iic-jku/ihp-sg13g2-ams-chip-template/doc/README.md

# Documentation

Reference material for this chip and for the IHP SG13G2 Open-PDK it is built on.

## This chip

| Document | Contents |
| --- | --- |
| [specifications.md](specifications.md) | Top-level specifications: technology, supplies, clock, corner list, macro inventory, functional behaviour of every block. |
| [pinout.md](pinout.md) | The full 32-pad table per side, with the `chip_top` port and the role each pad carries inside `chip_core`. |
| [floorplan.md](floorplan.md) | Die and core geometry, hard-macro placement coordinates, the PDN strategy and the floorplan diagram. |

The three are cross-linked and are written against the design files, not the other way round. If you change a number in [flow/librelane/config.yaml](../flow/librelane/config.yaml), [rtl/](../rtl/) or [packaging/config.yaml](../packaging/config.yaml), mirror it here.

## Tools

| Document | Contents |
| --- | --- |
| [klayout/klayout_cheatsheet.md](klayout/klayout_cheatsheet.md) | KLayout for this PDK: shortcuts, the `SG13_dev` PCell list, layer roles, padframe components, the DRC and LVS menu entries. |
| [librelane/librelane_cheatsheet.md](librelane/librelane_cheatsheet.md) | LibreLane `final/` directory anatomy, non-default routing rules, the complete SG13G2 via and metal-stack tables, the eight LEF/DEF orientations. |
| [verilog/](verilog/) | Verilog and SystemVerilog cheatsheets (external documents, PDK-independent). |

## PDK

| Document | Contents |
| --- | --- |
| [ihp-sg13g2-Open-PDK/sg13g2_os_layout_rules.pdf](ihp-sg13g2-Open-PDK/sg13g2_os_layout_rules.pdf) | The IHP layout rules. The authoritative source when a tool deck and a datasheet disagree. |
| [ihp-sg13g2-Open-PDK/sg13g2_os_process_spec.pdf](ihp-sg13g2-Open-PDK/sg13g2_os_process_spec.pdf) | The IHP process specification. |
| [ihp-sg13g2-Open-PDK/sg13g2_os_layout_cheatsheet.xlsx](ihp-sg13g2-Open-PDK/sg13g2_os_layout_cheatsheet.xlsx) | One sheet of formulas for wire resistance, parasitic capacitance and DC current limits. Read the caveats below before using it. |
| [ihp-sg13g2-Open-PDK/sg13g2_ngspice_mc_mm_guide.md](ihp-sg13g2-Open-PDK/sg13g2_ngspice_mc_mm_guide.md) | How the ngspice model files fit together, what `mm_ok` and `num_sigmas` do, and which corner, Monte Carlo and mismatch runs are possible per device family. |
| [sizing/](sizing/) | gm/ID techsweep plot overviews for the LV and HV MOS devices, the data behind the sizing notebooks in [macros/inverter/scripts/sizing/](../macros/inverter/scripts/sizing/). |

## Other

[ihp-structure-proposals/](ihp-structure-proposals/) holds four proposed submission-repo layouts for IHP shuttle chips (an ADC, an LNA, an MCU and an op-amp), contributed to the discussion around a common directory structure. They are PDK-independent. The generator script that produced them, `gen_structure.py`, is deliberately not tracked (see [.gitignore](../.gitignore)).

## Provenance and caveats

- **The two PDK PDFs come from `libs.doc/doc/` of the PDK**, renamed to lower case to match the folder convention. Both are byte-identical to the copies the PDK ships as of 2026-08-25 (`IHP-Open-PDK @ bf898e9`, the PDK in the IIC-OSIC-TOOLS 2026.08 image): layout rules **Rev. 0.4 (2024-12-19)**, process specification **Rev. 1.2 (2023-12-20)**. The revision is on the title page of each document. A repo copy of a PDK document ages silently, so check that stamp against `$PDK_ROOT/$PDK/libs.doc/doc/` before letting one of these decide a rule.
- **The layout cheatsheet is a convenience, not a rule source.** Its resistance columns assume bulk-aluminium resistivity and come out roughly a factor of two optimistic against the `RESISTANCE RPERSQ` values in `sg13g2_tech.lef`, and its "min. Width" column lists 0.42 µm for TopMetal1 and 0.2 µm for TopMetal2 where the tech LEF says 1.64 µm and 2.0 µm (0.42 is the TopVia1 cut size). Take widths from the DRC deck, resistance from the tech LEF or from PEX, and the DC current limits from the tables in the [LibreLane cheatsheet](librelane/librelane_cheatsheet.md), which are read out of the tech LEF. The sheet's `Contact` current limit of 0.3 mA per cut exists only there, the tech LEF has no `DCCURRENTDENSITY` entry for `Cont`.
- **Nothing in `doc/` is generated by a make target.** It is all hand-maintained.
