iic-jku/ihp-sg13g2-ams-chip-template/doc/klayout/klayout_cheatsheet.md

# KLayout IHP Cheat Sheet

## Plugins

- **Productivity Suite** by Martin Köhler:

  <https://github.com/iic-jku/klayout-productivity-suite>

---

## Layout Tips

- Layout an inverter first and go through all the design steps and get used to KLayout.
- Place dummy resistors with minimum length above and below the actual resistor.
- Use alternating metal layers for horizontal (M3/M5/TM2) and vertical (M2/M4/TM1) connections to minimize coupling.
- Restrict routing within the sub-circuit to lower metal layers: M1-M3
- Route sensitive signals first.
- Avoid the shadowing effect (orient the bias transistor in the same direction as the mirror transistor).
- Use self-made decoupling capacitors with NMOS capacitors at the bottom (for low-Q decoupling) and metal capacitors between each layer with alternating (vertical and horizontal) VIA contacts.
  - This fixes ringing that would otherwise occur when bond-wire inductance and high-Q MIM capacitors resonate.
  - Example stack: NMOS (VDD) → M1 (VSS) → M2 (VDD), again alternating vertical and horizontal.
  - Alternative: Use PMOS instead of NMOS, as this often is recommended for better ESD robustness.
- **RF decoupling:** Add an additional RC circuit in series with the supply voltage.

---

## Project Start

1. Open KLayout in edit mode with `klayout -e` (or `ke`).
2. **File → New Layout**:
    - Choose top cell name
    - Set **Data Base Unit (DBU)** to **0.001 µm** → IMPORTANT for IHP Open-PDK*
3. **File → Open** a hierarchical layout (`.klay.gds`), which allows sub-cells / sub-cell trees.
4. Hide empty layers.
5. Place instances by selecting and dragging them in.

\* If the DBU has been set wrong (e.g. to **0.005 µm**), change the DBU and scale the layout accordingly afterwards:
- **File → Layout Properties** → set DBU = `0.001 µm`
- **Edit → Layout → Scale** → enter `5.0` → press **OK** only (not *Apply + OK*, otherwise it scales 25 times → reported KLayout bug)
---

## Add Shortcuts

1. **File → Setup**
2. Customize Menu
3. Search for function and enter shortcut

---

## Net Tracer

1. **Tools → Trace Net**
2. Configure: tick `Halo`, `line width` = 3pixel, 90% `intensity increase`
3. Search for function and enter shortcut

---

## Enable Layer Numbers

1. **File → Setup**
2. Layer Properties
3. Tick *Always show layer source in layer list*

---

## Libraries (`.klib` File, Hierarchical Layout Only)

- Add entries in the `.klib` file:
  - Manually directly to the `.klib` file
  - In the GUI via "File / Cell Library Manager Map"
- Works for both `.gds` and `.klay.gds`.
- Build the cell tree bottom-up.

Common SG13_dev PCells:

- Transistors: `pmos`, `nmos` (low-voltage)
- Resistors: `rppd`, `rsil`, `rhigh`
- Capacitors: `cmim`
- Well/substrate contacts: `guard_ring`
- Vias:
  - `via_stack` from `SG13_dev`
  - `Via` from `SG13_native_pcell_lib library`
- etc.

---

## Layer Roles

- `MetalX.drawing`: actual connections
- `MetalX.pin`: input, output, inout pins placement
- `MetalX.text`: label of the pins
- Use filler layers later for final density closure.

---

## Padframe

| Component | Notes |
| --- | --- |
| Seal ring | Place at origin with `Shift + O` (25 µm offset) |
| IHP Pads | |
| RF Pads | add VIA ring for robustness |
| IO Pads | 3.3 V |
| VDD / VSS Pads | 1.5 V |
| Bond Pads | 70µm x 70µm |

---

## Shortcuts

### General Editing

| Shortcut | Action |
| --- | --- |
| `Q` | Properties of selected objects/pcells |
| `P` | Path / drawing tool (double-click to finish) |
| `U` | Undo |
| `Shift + U` | Redo |
| `F` | Zoom full |
| `R` | Draw rectangle |
| `A` | Align tool: click on dot (middle / corner / edge) |
| `C` | Copy object |
| `M` | Move quickly (connections & movements: diagonal) |
| `T` | Place text |
| `K` | Ruler+ |
| `Shift + K` | Clear all Ruler+s |
| `Shift + C` | Toggle Crosshair Cursor |

### Pins & VIAs

| Shortcut | Action |
| --- | --- |
| `Shift + P` | Set pin (input, output, …) for LVS |
| `O` | Place VIAs during routing (pathmode) |
| | Manual VIA stack via IHP Pcells → drag out → `Q` → set layer input |

### Instance Manipulation

| Shortcut | Action |
| --- | --- |
| `E` | Descend into instance |
| `Ctrl + E`  | Ascend from instance |
| Middle Mouse Button | Show As New Top	 |
| `Shift + R` | Rotate instance by 90° |
| `Shift + H` | Flip instance horizontally |
| `Shift + V` | Flip instance vertically |
| `Shift + O` | Set origin |

### Hierarchy Visibility

| Shortcut | Action |
| --- | --- |
| `Ctrl + F`  | Hide all instances per hierarchy level |
| `Shift + F` | Show all instances per hierarchy level |

### Layer Visibility

| Key | Layer Focus |
| --- | --- |
| `0` | Show default layers |
| `,` | Hide default layers |
| `1` | 1st metal and related VIAs |
| `2` | 2nd metal and related VIAs |
| `3` | 3rd metal and related VIAs |
| `4` | 4th metal and related VIAs |
| `5` | 5th metal and related VIAs |
| `6` | 6th metal and related VIAs |
| `7` | 7th metal and related VIAs |
| `8` | Gate poly and related layers |
| `9` | Diffusion and related layers |
| `Shift+1` | Extend the focus to include 1st metal and related vias |
| `Shift+2` | Extend the focus to include 2nd metal and related vias |
| `Shift+3` | Extend the focus to include 3rd metal and related vias |
| `Shift+4` | Extend the focus to include 4th metal and related vias |
| `Shift+5` | Extend the focus to include 5th metal and related vias |
| `Shift+6` | Extend the focus to include 6th metal and related vias |
| `Shift+7` | Extend the focus to include 7th metal and related vias |
| `Shift+8` | Extend the focus to include Gate Poly and related vias |
| `Shift+9` | Extend the focus to include Diffusion and related vias |

---

## LVS (Layout vs. Schematic)

- Open-Source Tool Check
  - Xschem:
    - **Simulation → LVS → untick "Use 'spiceprefix' attribute"**
    - **Simulation → LVS → tick "LVS netlist + Top level is a .subckt" and "Upper case .SUBCKT and .ENDS"**
    - **Simulation → "Set top level netlist name" → enter top level netlist name (equals file name + `.cdl` or `.spice`)**
    - **Right top corner → click on "create netlist" → creates a `.cdl` or `.spice` file**
  - KLayout:
    - Rename the cell to match the LVS netlist name
    - **SG13G2 → SG13G2 LVS Options (`F12`) → set "Netlist Path"**
    - **Run KLayout LVS (`F11`)**

---

## DRC (Design Rule Check)

- Open-Source Tool Check
  - KLayout:
    - **SG13G2 → SG13G2 DRC Options (`F10`)**
      - Set the extra rule set (do **not** disable it).
      - **Advanced settings:**
        - Disable density checks (only at the beginning).
        - Enable antenna checks.
    - **Run KLayout DRC (`F9`)**

---

## Makefiles

- Every macro folder contains Makefile targets for common verification and extraction flows, including DRC, LVS, and PEX with KLayout or Magic & Netgen.

---
