iic-jku/ihp-sg13g2-ams-chip-template/ip/sg13g2_ip__jku_names/README.md

# sg13g2_ip__jku_names

A names IP block for [Johannes Kepler University Linz](https://www.jku.at/), rendered as a GDSII layout on a configurable metal layer (default `Metal5`) with `NoMetFiller` for the IHP SG13G2 130 nm CMOS process.

## Directory Structure

<details>
<summary>Show Directory Structure</summary>

```text
📁 sg13g2_ip__jku_names/
├─ Makefile                         # Build automation
├─ 📁 logo/
│  └─ jku_names.png                 # Source PNG image
├─ 📁 script/
│  └─ img2lay.py                    # PNG-to-GDS converter
├─ 📁 final/
│  ├─ 📁 gds/
│  │  └─ sg13g2_ip__jku_names.gds   # Generated GDSII layout
│  ├─ 📁 lef/
│  │  └─ sg13g2_ip__jku_names.lef   # LEF macro for place-and-route
│  ├─ 📁 lib/
│  │  └─ sg13g2_ip__jku_names.lib   # Liberty timing stub
│  └─ 📁 vh/
│     └─ sg13g2_ip__jku_names.vh    # Verilog blackbox stub
└─ 📁 verification/
   └─ 📁 drc/                       # DRC reports
```

</details>

## Usage

The default Make target is `help`, so running `make` prints usage and all available targets with short descriptions.

```bash
make
make help
```

Build everything (clean, generate logo GDS, LEF, Liberty, Verilog stub, run DRC):

```bash
make all
```

### Individual Targets

| Target | Description |
|---|---|
| `logo` | Convert PNG to GDSII using `img2lay.py` |
| `lef` | Generate LEF macro (CLASS BLOCK, OBS on `$(LAYER_NAME)`) |
| `lib` | Generate Liberty timing stub (empty cell) |
| `verilog` | Generate Verilog blackbox stub (no ports) |
| `klayout-drc` | Run KLayout DRC using `sak-drc.sh` (usage: `make klayout-drc [CELL=<cellname>] [DRC_LEVEL=<precheck\|macro\|regular>]`) |
| `magic-drc` | Run Magic DRC using `sak-drc.sh` (usage: `make magic-drc [CELL=<cellname>]`) |
| `open` | Browse this folder with `sak-open.py` and open each file in its tool |
| `clean` | Remove all generated output directories |

### Parameters

The following Makefile variables can be overridden:

| Variable | Default  | Description |
|---|---|---|
| `IMG_SIZE_PX` | `750` | Source image width/height in pixels |
| `BLOCK_SIZE`  | `100` | Desired physical block size in µm |
| `PIXEL_SIZE`  | `0.25` | Pixel size in µm (must be ≥ M5 min width of 0.21 µm to avoid DRC violations) |
| `LAYER` | `Metal5` | Metal layer the logo is drawn on; one of `Metal1`..`Metal5`, `TopMetal1`, `TopMetal2` |

Setting `LAYER` keeps the GDS artwork (`logo` target) and the LEF obstruction (`lef` target) consistent. The Makefile derives both `LAYER_NUM` (e.g. `67/0`) and `LAYER_NAME` (e.g. `Metal5`) from it.

```sh
make all LAYER=TopMetal1
```

The image scale factor is computed automatically.

## Logo Generator Script

The `script/img2lay.py` script converts a PNG image into a GDSII layout:

- Each dark pixel becomes a rectangle on the layer selected via `LAYER` (default `Metal5` → `67/0`)
- Boundary layers 189/0 (`prBoundary`) and 160/0 (`NoMetFiller`) mark the block outline
- `--invert` inverts the image (dark ↔ light)
- `--merge` merges adjacent rectangles to reduce polygon count
- `--pixel-size` sets the physical size of each pixel in µm
- `--scale` downscales the image before conversion

## Design Rule Check (DRC)

Runs DRC on the GDS layout in `final/gds/`. Both flows use `sak-drc.sh` and write their reports into per-cell run folders: `verification/drc/<CELL>.magic.drc/` (Magic) and `verification/drc/<CELL>.klayout.drc/` (KLayout, `.lyrdb`).

**KLayout DRC** uses `sak-drc.sh` at the selected `DRC_LEVEL` (`precheck`, `macro` [default], or `regular`):

```sh
make klayout-drc
make klayout-drc CELL=sg13g2_ip__jku_names
make klayout-drc DRC_LEVEL=regular
```

**Magic DRC** uses `sak-drc.sh`:

```sh
make magic-drc
make magic-drc CELL=sg13g2_ip__jku_names
```
