iic-jku/ihp-sg13g2-ams-chip-template/doc/ihp-structure-proposals/IHP__ADC5871-structure.md

# IHP__ADC5871 structure

```
📁 IHP__ADC5871/
├── 📁 ADC5871-main/
│   ├── 📁 layout/
│   │   ├── 📁 def/
│   │   ├── 📁 klayout/
│   │   ├── 📁 lef/
│   │   └── 📁 magic/
│   ├── 📁 model/
│   │   ├── 📁 spice/
│   │   └── 📁 verilog-A/
│   ├── 📁 netlist/
│   │   ├── 📁 layout/
│   │   ├── 📁 pex/
│   │   ├── 📁 rcx/
│   │   └── 📁 schematic/
│   ├── 📁 schematic/
│   │   ├── 📁 qucs-s/
│   │   └── 📁 xschem/
│   ├── 📁 testbenches/
│   │   ├── 📁 ac/
│   │   │   ├── 📁 qucs-s/
│   │   │   └── 📁 xschem/
│   │   ├── 📁 corners/
│   │   │   ├── 📁 qucs-s/
│   │   │   └── 📁 xschem/
│   │   ├── 📁 noise/
│   │   │   ├── 📁 qucs-s/
│   │   │   └── 📁 xschem/
│   │   └── 📁 tran/
│   │       ├── 📁 qucs-s/
│   │       └── 📁 xschem/
│   ├── 📁 timing/
│   ├── 📁 verification/
│   │   ├── 📁 drc/
│   │   └── 📁 lvs/
│   └── README.md
├── 📁 dependencies/
├── 📁 doc/
│   ├── Datasheet.md
│   ├── info.json
│   ├── Specification.md
│   └── TRL-Mixed-Signal-IP.md
├── 📁 measurements/
│   └── 📁 v.1.0.0/
├── 📁 release/
│   └── 📁 v.1.0.0/
│       ├── 📁 doc/
│       ├── 📁 gds/
│       ├── 📁 netlist/
│       └── ReleaseNote.md
└── README.md
```
