iic-jku/ihp-sg13g2-ams-chip-template/doc/ihp-structure-proposals/IHP__LNA1426-structure.md

# IHP__LNA1426 structure

```
📁 IHP__LNA1426/
├── 📁 dependencies/
├── 📁 doc/
│   ├── Datasheet.md
│   ├── info.json
│   ├── Specification.md
│   └── TRL-RF.md
├── 📁 LNA1426-main/
│   ├── 📁 layout/
│   │   ├── 📁 def/
│   │   ├── 📁 klayout/
│   │   ├── 📁 lef/
│   │   └── 📁 magic/
│   ├── 📁 model/
│   │   ├── 📁 spice/
│   │   └── 📁 verilog-A/
│   ├── 📁 netlist/
│   │   ├── 📁 layout/
│   │   ├── 📁 pex/
│   │   ├── 📁 rcx/
│   │   └── 📁 schematic/
│   ├── 📁 schematic/
│   │   ├── 📁 qucs-s/
│   │   └── 📁 xschem/
│   ├── 📁 testbenches/
│   │   ├── 📁 ac/
│   │   │   ├── 📁 qucs-s/
│   │   │   └── 📁 xschem/
│   │   ├── 📁 corners/
│   │   │   ├── 📁 qucs-s/
│   │   │   └── 📁 xschem/
│   │   ├── 📁 em/
│   │   ├── 📁 noise/
│   │   │   ├── 📁 qucs-s/
│   │   │   └── 📁 xschem/
│   │   └── 📁 tran/
│   │       ├── 📁 qucs-s/
│   │       └── 📁 xschem/
│   ├── 📁 verification/
│   │   ├── 📁 drc/
│   │   └── 📁 lvs/
│   └── README.md
├── 📁 measurements/
│   └── 📁 v.1.0.0/
├── 📁 release/
│   └── 📁 v.1.0.0/
│       ├── 📁 doc/
│       ├── 📁 gds/
│       ├── 📁 netlist/
│       └── ReleaseNote.md
└── README.md
```
