iic-jku/ihp-sg13g2-ams-chip-template/ToDo.md

# ToDo List

- [ ] update tutorial
    - no sizing guidance for `DIE_AREA`/`CORE_AREA` or the core ring
    - no explanation of `chip_top.sdc`
    - no description of the MACROS entry structure
    - no post-run checklist
- [ ] add VCO RF macro in branch `add-rf-macro`
- [ ] test and merge `hv-stdcell`: https://github.com/iic-jku/ihp-sg13g2-ams-chip-template/tree/test-hv-stdcell
- [ ] check and merge `gdscheck-drc`: https://github.com/iic-jku/ihp-sg13g2-ams-chip-template/pull/7
- [ ] `ngspice` & `verilog` RTL Co-Simulation using `Xschem`: https://www.youtube.com/watch?v=PPd7jkcHOgA
- [ ] add VACASK testbenches to inverter macro (update Makefile + README, see `add-vacask` branch)
- [ ] add VACASK mixed-signal GL testbenches to counter macro (update Makefile + README, see `add-vacask` branch)
- [ ] clean up top-level LVS (Magic + Netgen, KLayout ?) --> see / merge `top-level-lvs` branch
- [ ] merge `fixed-auto-taper` branch (wait until `librelane-openroad` is updated)
- [ ] finish and merge `exercise-solution` branch
- [ ] add custom LibreLane step for filler insertion after ArtistIC added logo --> see / merge `custom-librelane-steps` branch
    - flow without filler (GDS streamout + DRC check) --> default
    - add logo with ArtistIC --> custom
    - add filler structures --> custom
        - KLayout & Magic Filler: https://librelane.readthedocs.io/en/stable/reference/step_config_vars.html
        - add GDSFill to `config.yaml`: https://github.com/aesc-silicon/gdsfill 
    - GDS streamout + DRC check --> custom
- [ ] add custom LibreLane step for power estimation (counter macro & top-level)
- [ ] add sg13g2_Filler2000_novdd to split VDD_CORE & VDD_ANA (split voltage domains)
- [ ] add sg13g2_io_custom to iic-jku/IHP-Open-PDK
- [ ] add YouTube tutorial
- [ ] add Blender renders
- [ ] PR IHP sizing scripts
- [ ] RTL Co-Simulation using `SpiceBind`
- [ ] add PF SimulatePARALLEL testbench
- [ ] save markdown report of CACE
- [ ] update table "Folder" column width
