iic-jku/ihp-sg13g2-ams-chip-template/macros/counter/render/img/counter_top_librelane.png

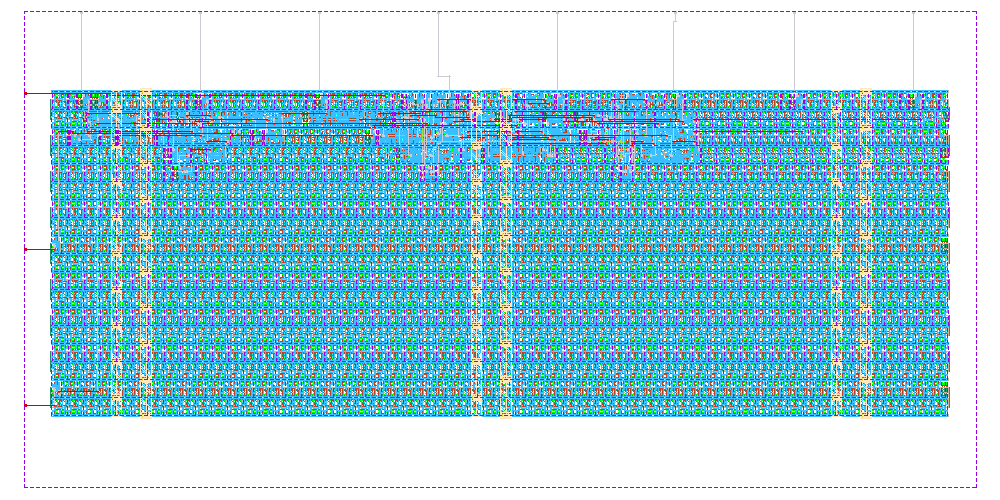
macros/counter/render/img/counter_top_librelane.png
