iic-jku/ihp-sg13g2-ams-chip-template/macros/inverter/render/img/inverter_top_black.png

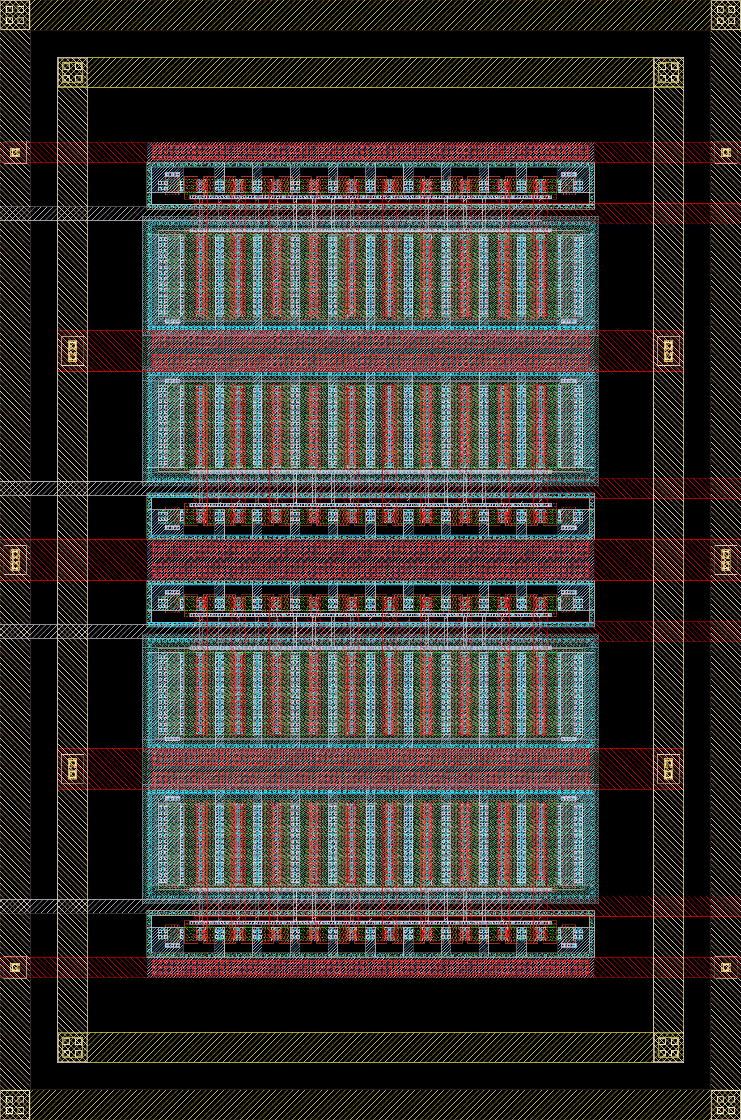
macros/inverter/render/img/inverter_top_black.png
