iic-jku/ihp-sg13g2-ams-chip-template/packaging/render/chip_top_bondplan_black.png

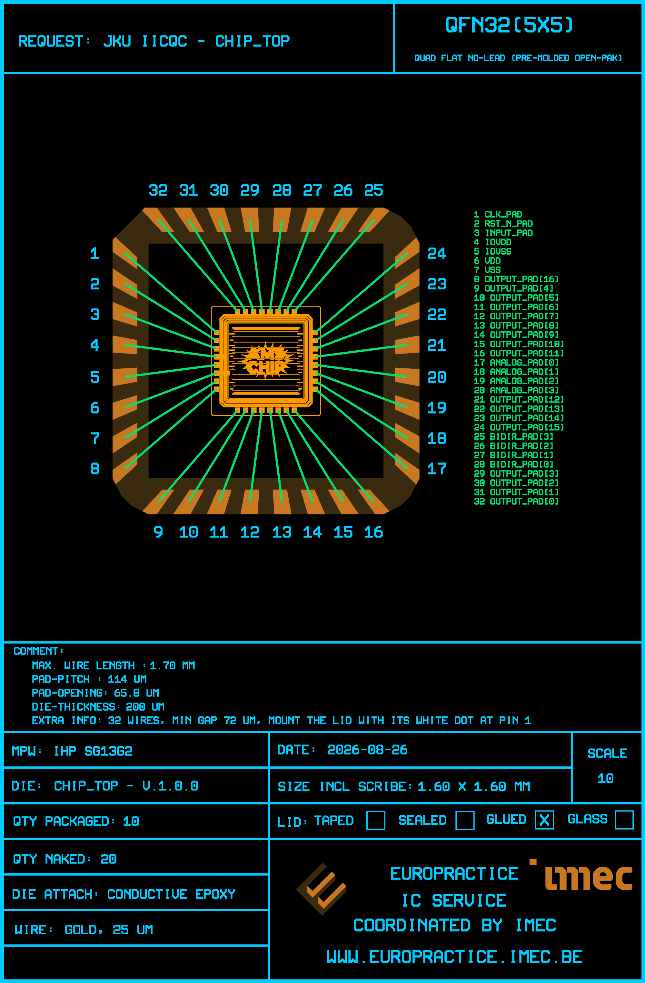
packaging/render/chip_top_bondplan_black.png
