iic-jku/ihp-sg13g2-ams-chip-template/release/v.1.0.0/img/chip_top_black_TM2.png

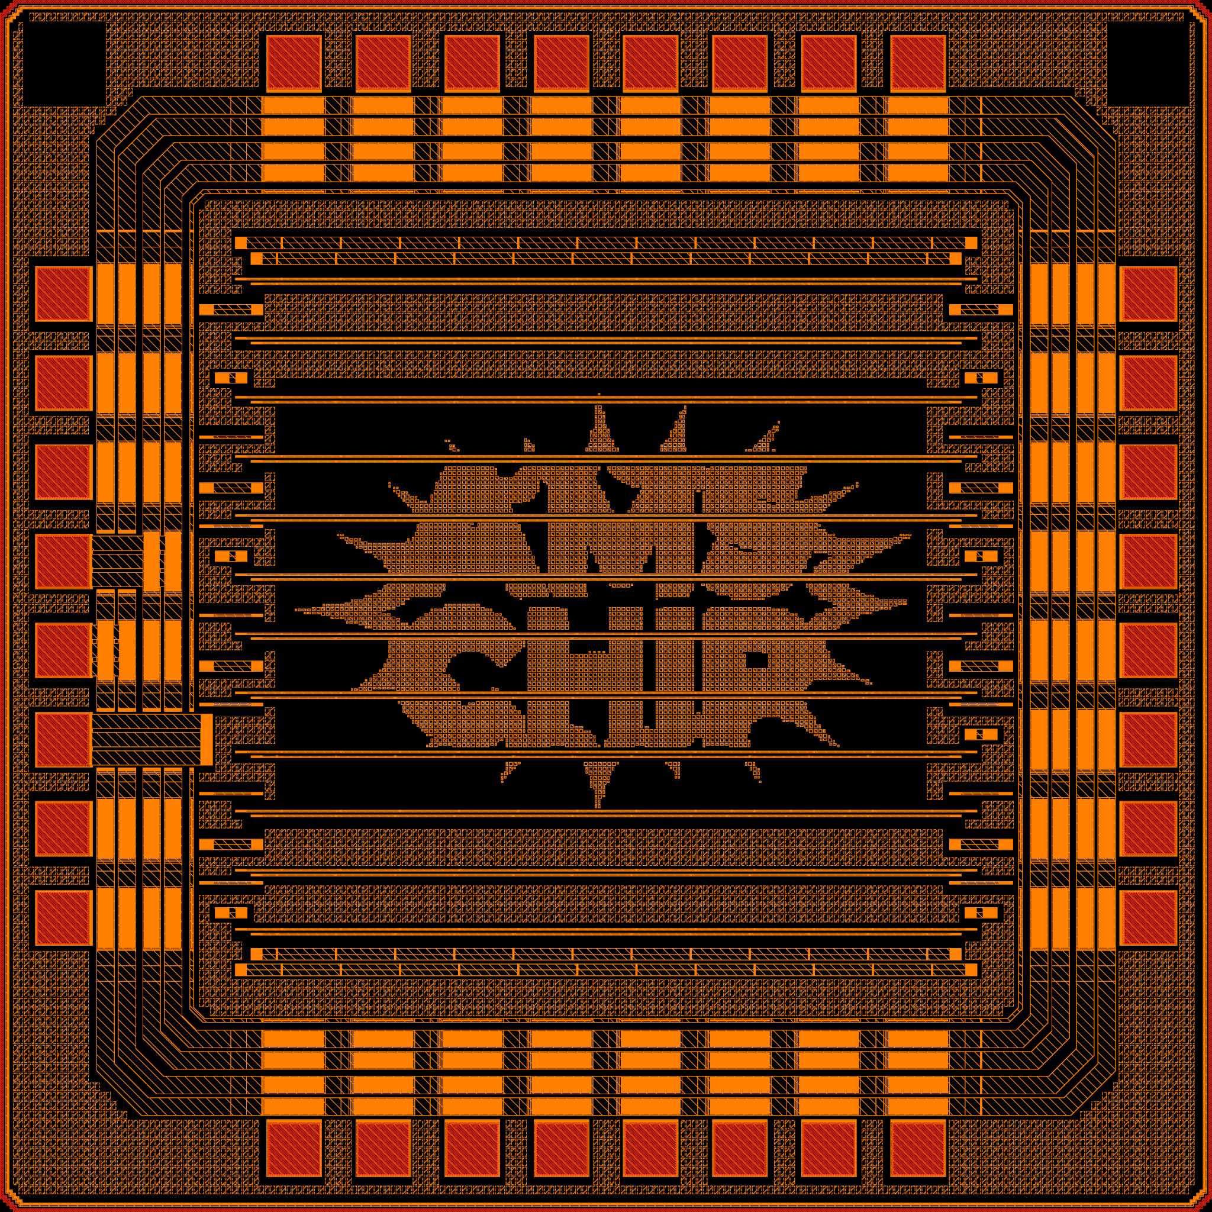
release/v.1.0.0/img/chip_top_black_TM2.png
