iic-jku/ihp-sg13g2-ams-chip-template/release/v.1.0.0/img/chip_top_librelane.png

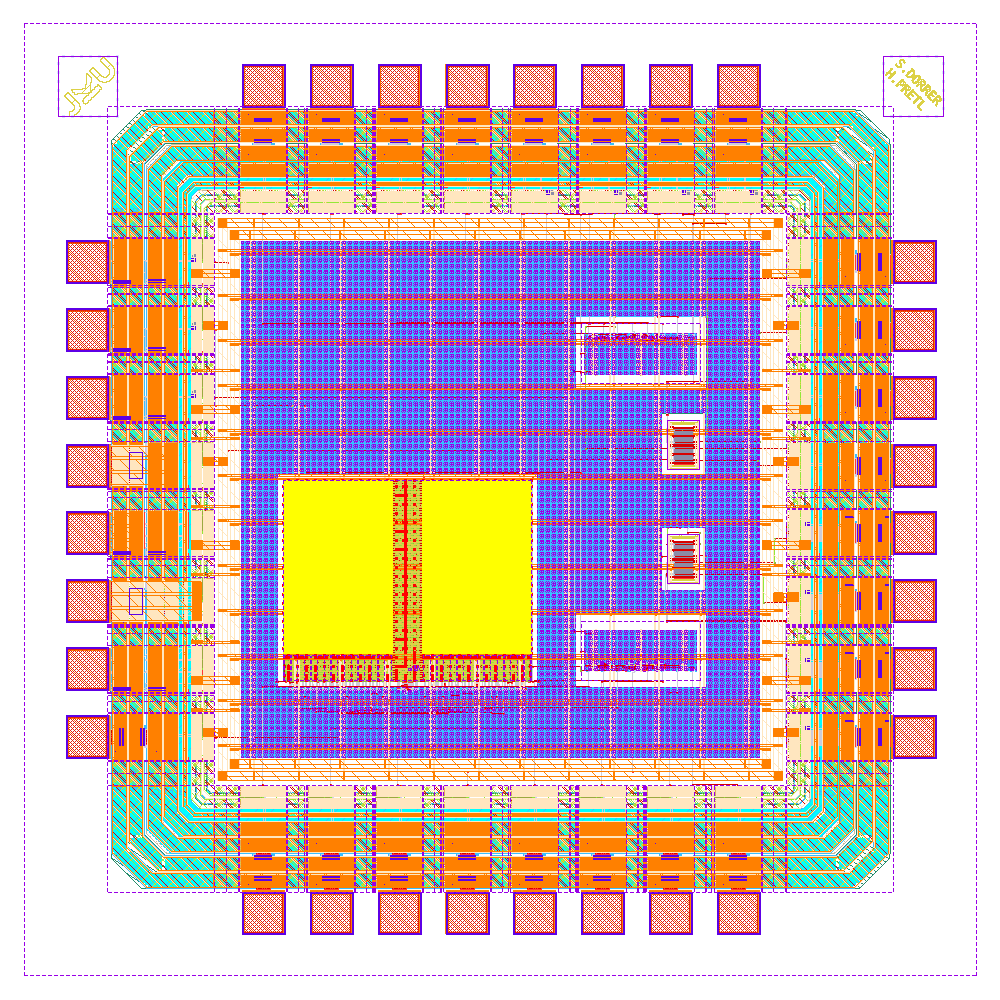
release/v.1.0.0/img/chip_top_librelane.png
