iic-jku/ihp-sg13g2-ams-chip-template/tutorial/fig/tools_overview/tools_overview.png

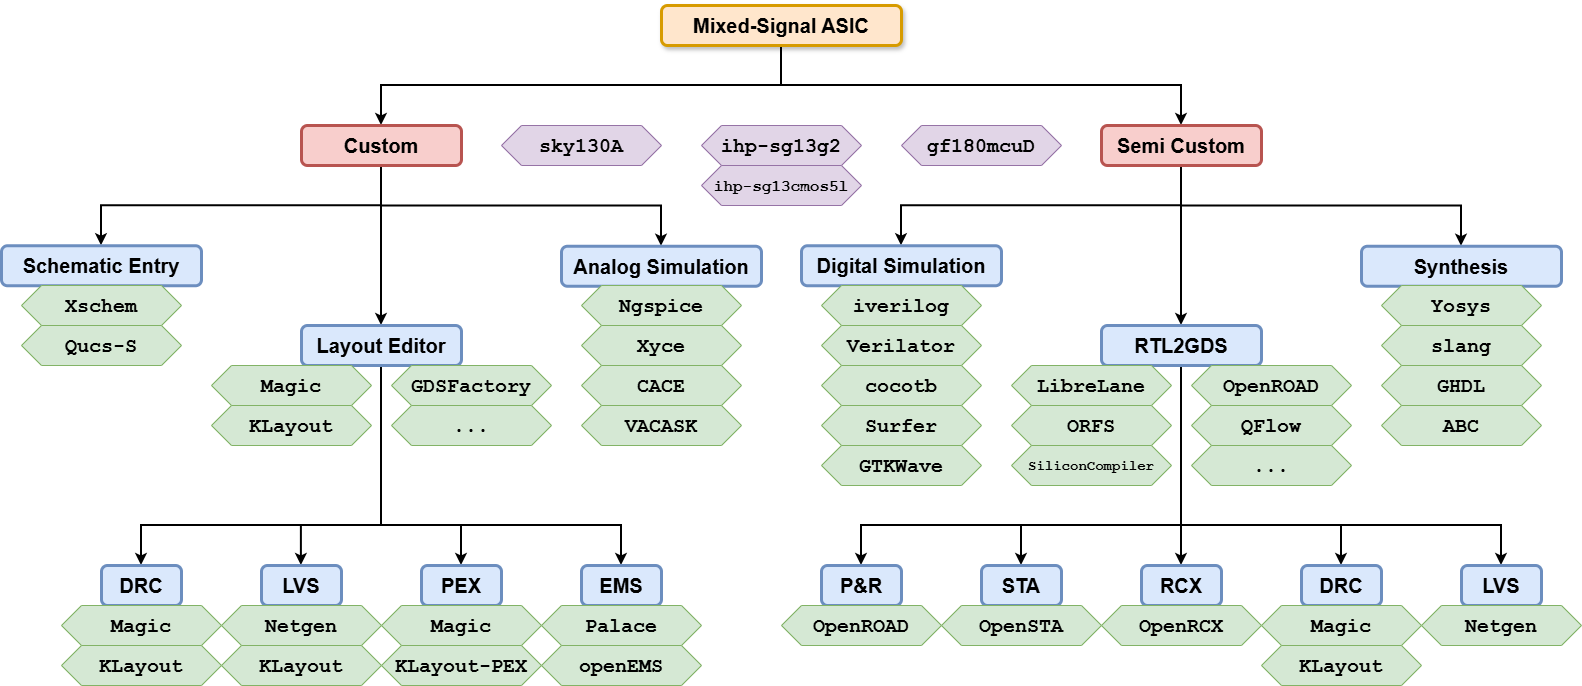
tutorial/fig/tools_overview/tools_overview.png
