iic-jku/ihp-sg13g2-ams-chip-template/macros/inverter/testbenches/xschem/plot_simulations/figures/inverter_tb_ac_ol.pdf

### Inverter - AC Open-Loop Response

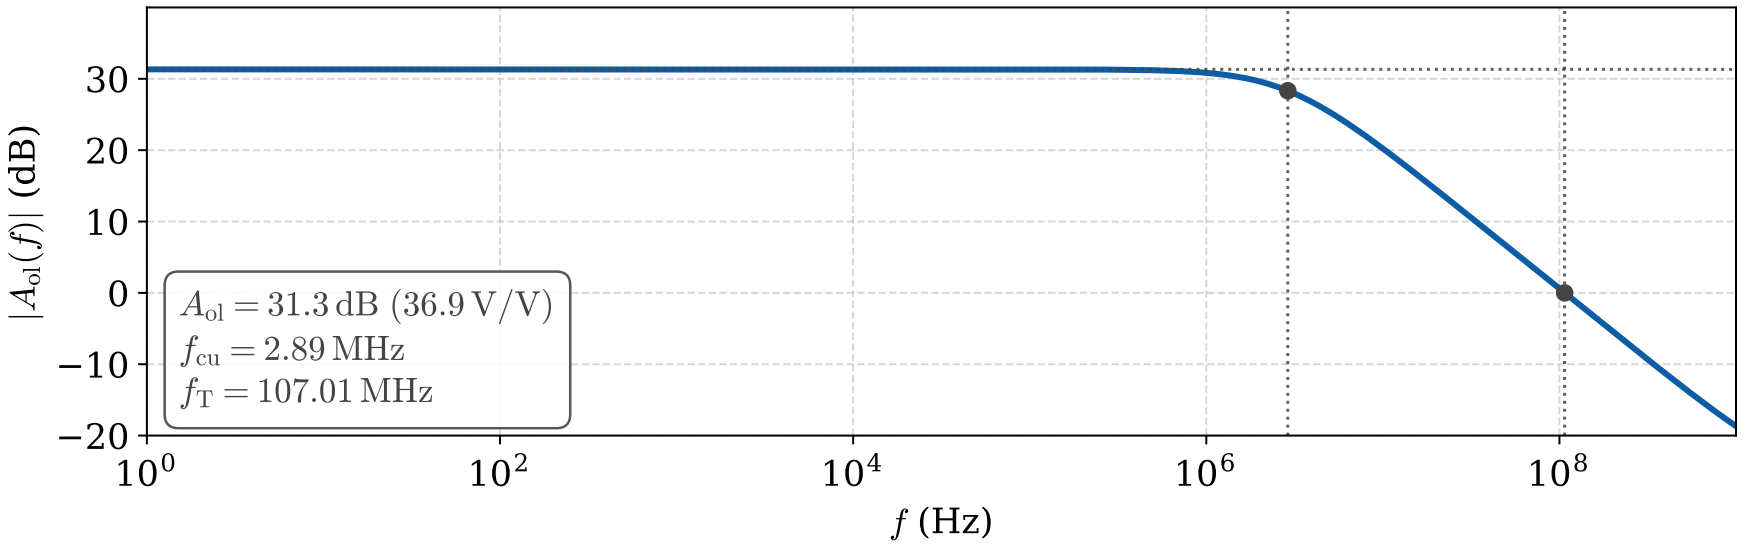
[picture p72: figure]
jAol(f)j (d; Aol = 31:3 dB (36:9 V=V) fcu = 2:89 MHz; fT = 107:01 MHz
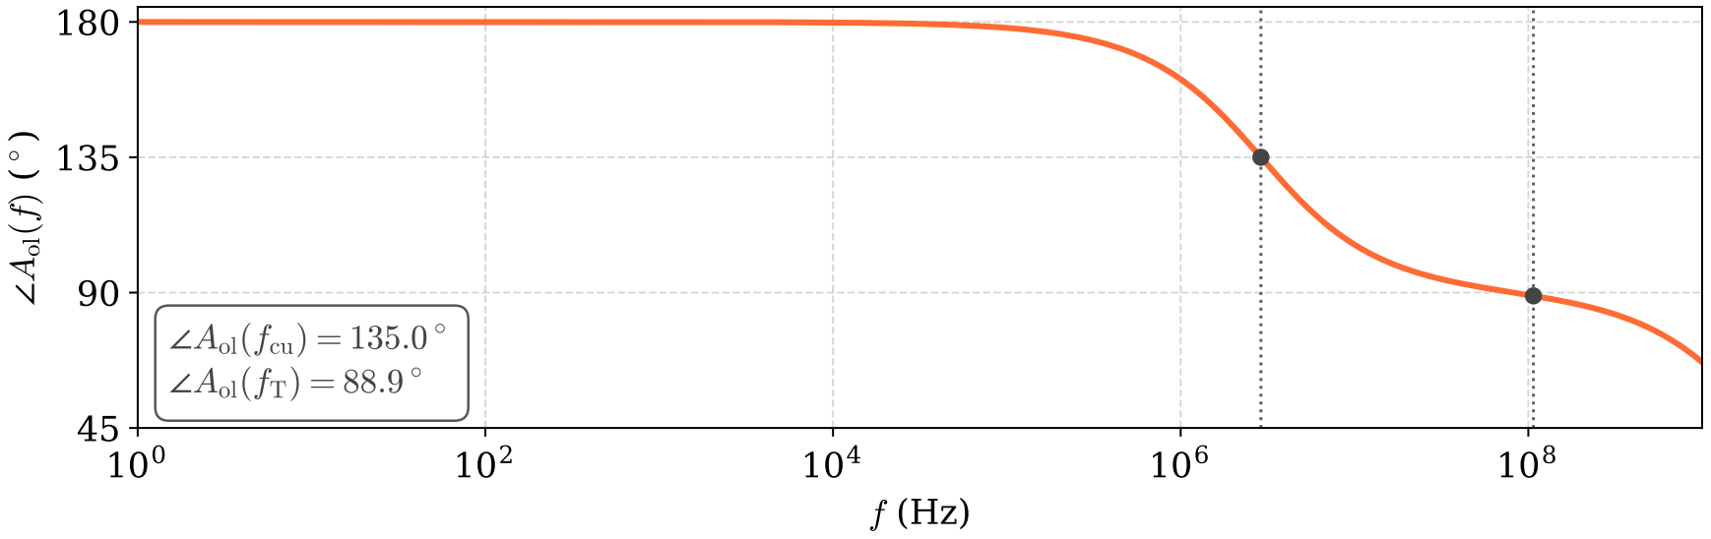
[picture p73: figure]
Aol(f) (; ∠Aol(fcu) = 135:0; ∠Aol(fT) = 88:9
