iic-jku/ihp-sg13g2-ams-chip-template/testbenches/xschem/plot_simulations/figures/chip_top_tb_tran_analog_inv.pdf

Chip Top

— Analog Inverter (INV2)

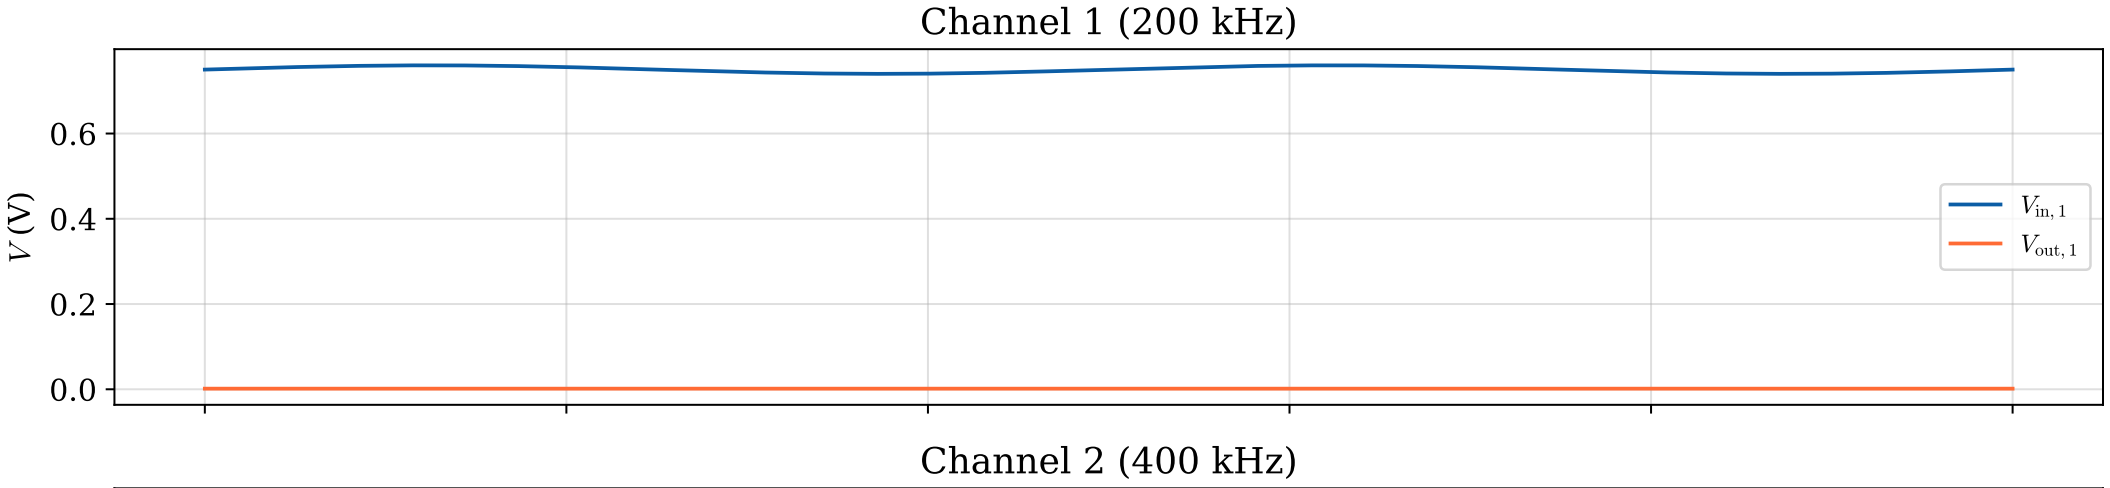
[picture p74: figure]
Channel 1 (200 kHz); Channel 2 (400 kHz)
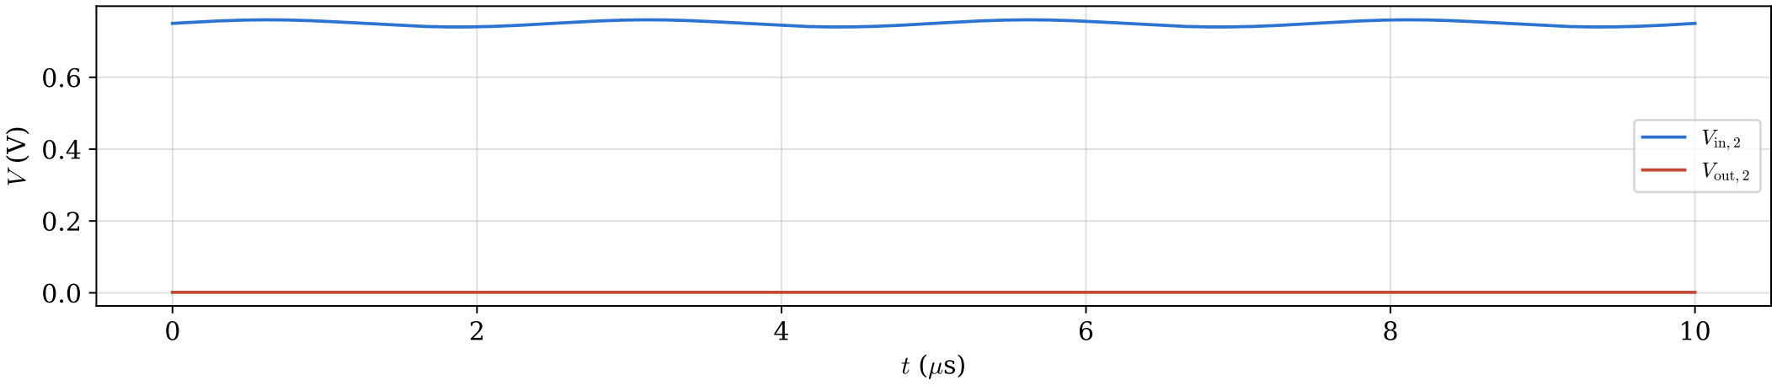
[picture p75: figure]
