iic-jku/ihp-sg13g2-ams-chip-template/macros/inverter/verification/cace/scripts/inverter_tb_ac.csv

Adc_ol_dB_arr | fcu_arr
3.233319999999999794e+01 | 2.770820000000000000e+06
1.569359999999999999e+01 | 1.498760000000000000e+07
1.684240000000000137e+01 | 1.415100000000000000e+07
3.355180000000000007e+01 | 2.253940000000000000e+06
1.964890000000000114e+01 | 1.016710000000000000e+07
3.318299999999999983e+01 | 2.432850000000000000e+06
1.549210000000000065e+01 | 1.466710000000000000e+07
1.714649999999999963e+01 | 1.217430000000000000e+07
8.209319999999999951e+00 | 3.240640000000000000e+07
2.650779999999999959e+01 | 4.716980000000000000e+06
1.192699999999999960e+01 | 2.323780000000000000e+07
1.591879999999999917e+01 | 1.531210000000000000e+07
9.953920000000000101e+00 | 2.865190000000000000e+07
1.524510000000000076e+01 | 1.604600000000000000e+07
3.349900000000000233e+01 | 2.284840000000000000e+06
3.252179999999999893e+01 | 2.516820000000000000e+06
3.022019999999999840e+01 | 3.188520000000000000e+06
2.313899999999999935e+01 | 7.092750000000000000e+06
7.639669999999999739e+00 | 3.074810000000000000e+07
1.581579999999999941e+01 | 1.614560000000000000e+07
6.617630000000000123e+00 | 3.729670000000000000e+07
1.583300000000000018e+01 | 1.536930000000000000e+07
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
