iic-jku/ihp-sg13g2-ams-chip-template/macros/inverter/testbenches/xschem/plot_simulations/figures/inverter_top_tb_tran.csv

time_ms | vin | vout1 | vout2 | vout3 | vout4
0.000000000000000000e+00 | 7.500000000000000000e-01 | 5.371804869999999843e-01 | 5.371804869999999843e-01 | 5.371804869999999843e-01 | 5.371804869999999843e-01
1.000000000000000082e-05 | 7.500006280000000025e-01 | 5.371769410000000189e-01 | 5.371769410000000189e-01 | 5.371769410000000189e-01 | 5.371769410000000189e-01
2.000000000000000164e-05 | 7.500012569999999767e-01 | 5.371703709999999798e-01 | 5.371703709999999798e-01 | 5.371703709999999798e-01 | 5.371703709999999798e-01
4.000000000000000327e-05 | 7.500025129999999818e-01 | 5.371512769999999826e-01 | 5.371512769999999826e-01 | 5.371512769999999826e-01 | 5.371512769999999826e-01
8.000000000000000654e-05 | 7.500050270000000463e-01 | 5.370932120000000420e-01 | 5.370932120000000420e-01 | 5.370932120000000420e-01 | 5.370932120000000420e-01
1.600000000000000131e-04 | 7.500100530000000099e-01 | 5.369363689999999689e-01 | 5.369363689999999689e-01 | 5.369363689999999689e-01 | 5.369363689999999689e-01
3.200000000000000262e-04 | 7.500201060000000197e-01 | 5.365749749999999541e-01 | 5.365749749999999541e-01 | 5.365749749999999541e-01 | 5.365749749999999541e-01
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
