iic-jku/ihp-sg13g2-ams-chip-template/macros/inverter/verification/cace/results/inverter/Adc_ol_dB_mc.png

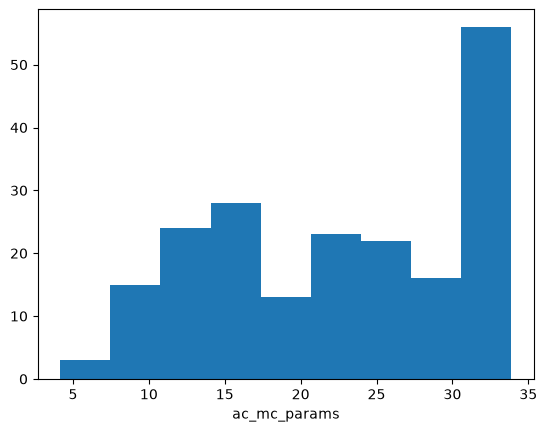
macros/inverter/verification/cace/results/inverter/Adc_ol_dB_mc.png
