iic-jku/ihp-sg13g2-ams-chip-template/macros/inverter/verification/cace/results/inverter/fcu_mc.png

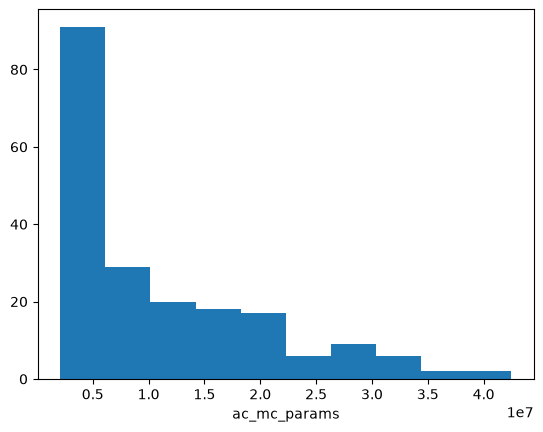
macros/inverter/verification/cace/results/inverter/fcu_mc.png
