iic-jku/ihp-sg13g2-ams-chip-template/doc/sizing/techsweep_sg13g2_lv_nmos_plots_overview.pdf

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

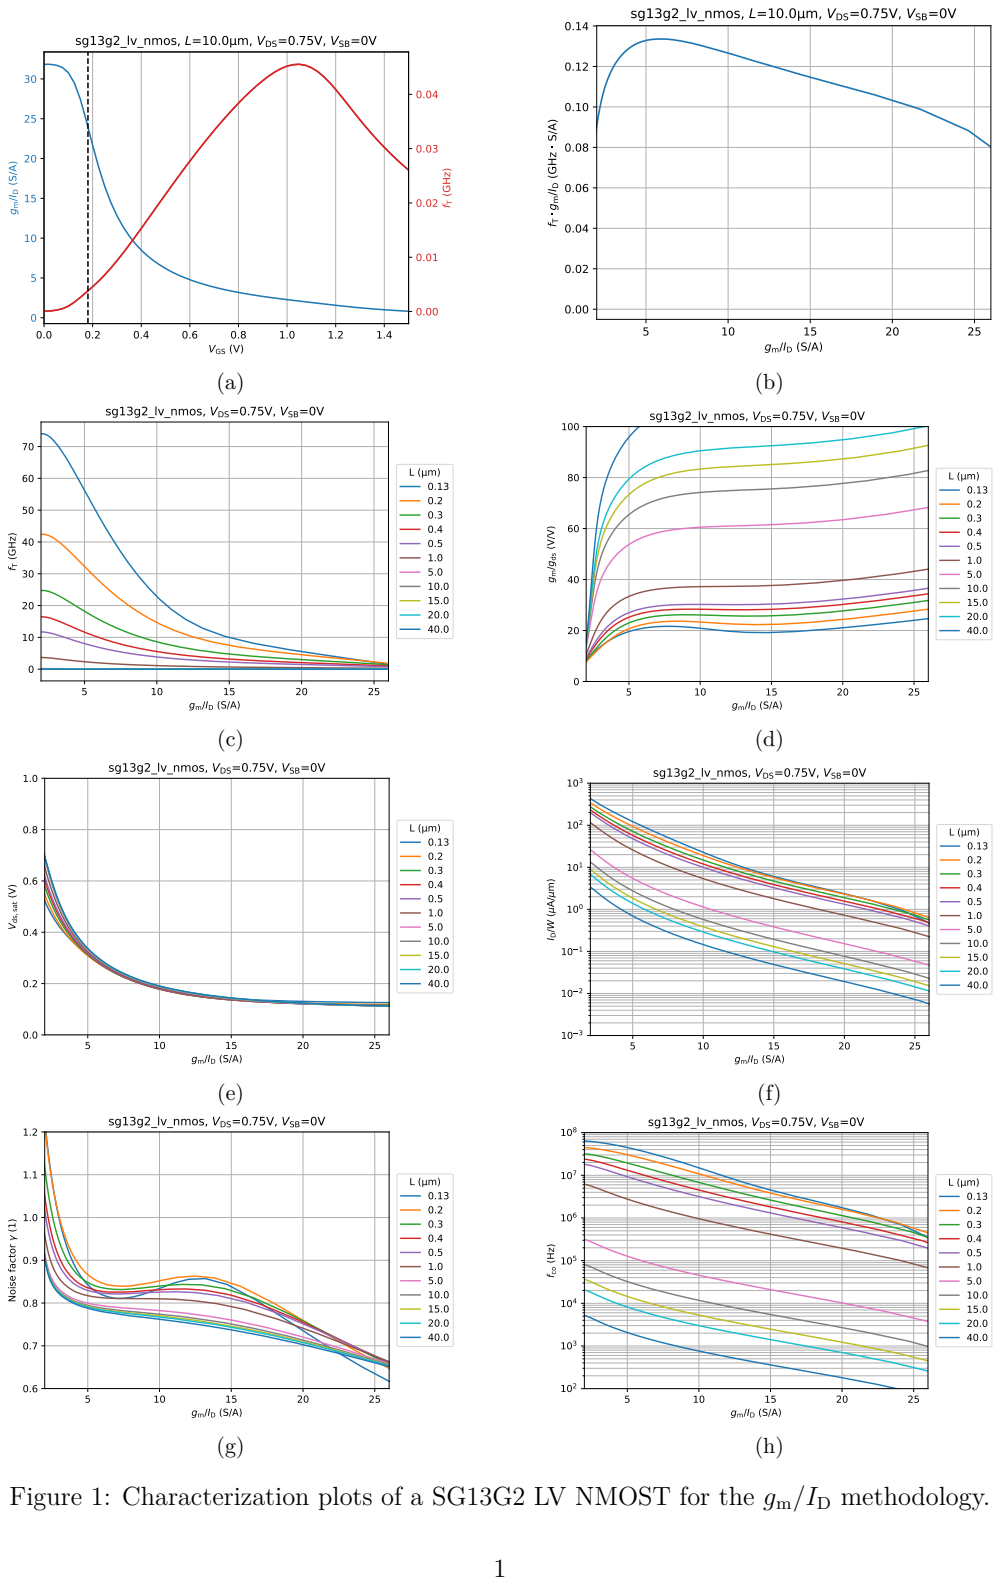
[picture p80: page 1]
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
