iic-jku/ihp-sg13g2-ams-chip-template/tutorial/fig/targets_overview/targets_overview.pdf

# make all

3. make sim-all | 1. make build-all | 2. make magic-drc

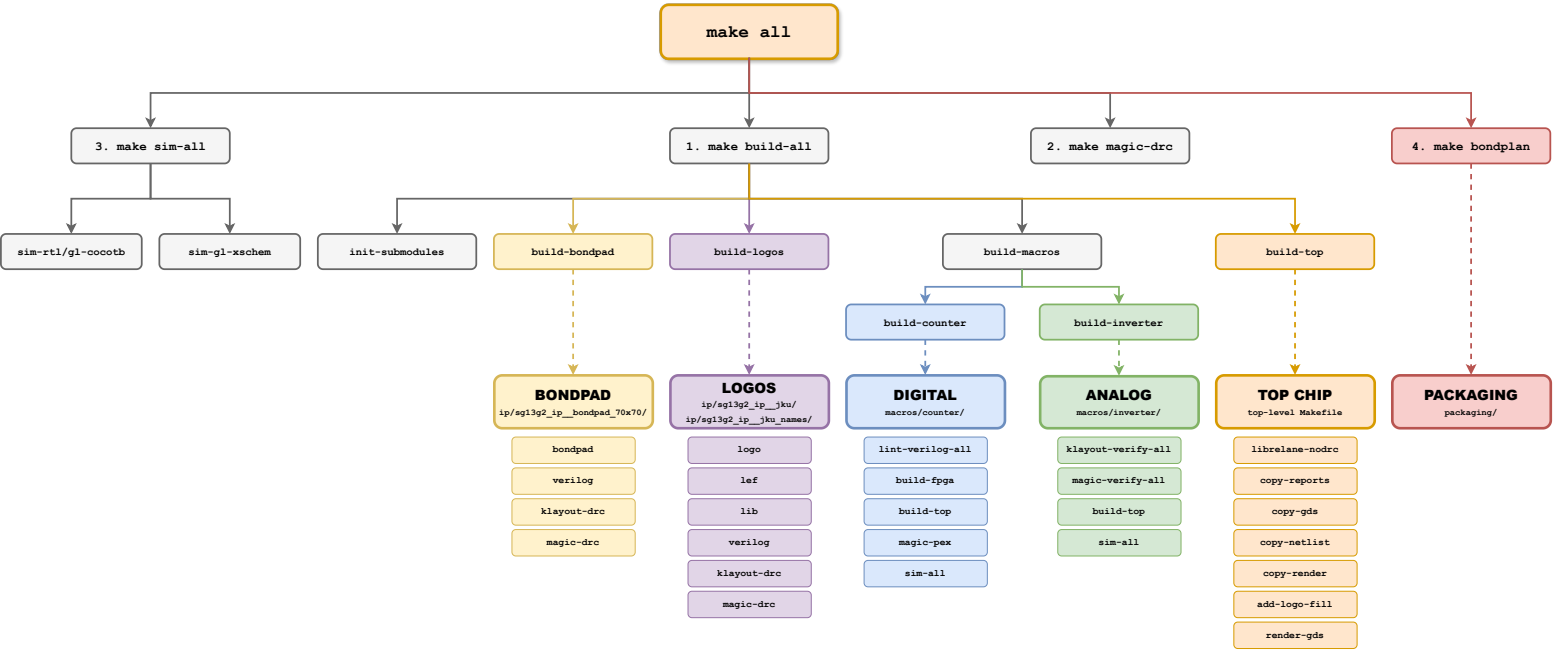
[picture p82: page 1]
sim-rtl/gl-cocotb; sim-gl-xschem; init-submodules; build-bondpad; build-logos; build-macros; build-top; build-counter; build-inverter; 4. make bondplan; PACKAGING; packaging/; BONDPAD; ip/sg13g2_ip__bondpad_70x70/; LOGOS; ip/sg13g2_ip__jku/; ip/sg13g2_ip__jku_names/; DIGITAL; macros/counter/; ANALOG; macros/inverter/; TOP CHIP; bondpad; verilog; klayout-drc; magic-drc; logo; lef; lib; build-fpga; magic-pex; sim-all; librelane-nodrc; copy-reports; copy-gds; copy-netlist; copy-render; render-gds

top-level Makefile

lint-verilog-all

klayout-verify-all

magic-verify-all

add-logo-fill
