iic-jku/ihp-sg13g2-ams-chip-template/tutorial/fig/tools_overview/tools_overview.pdf

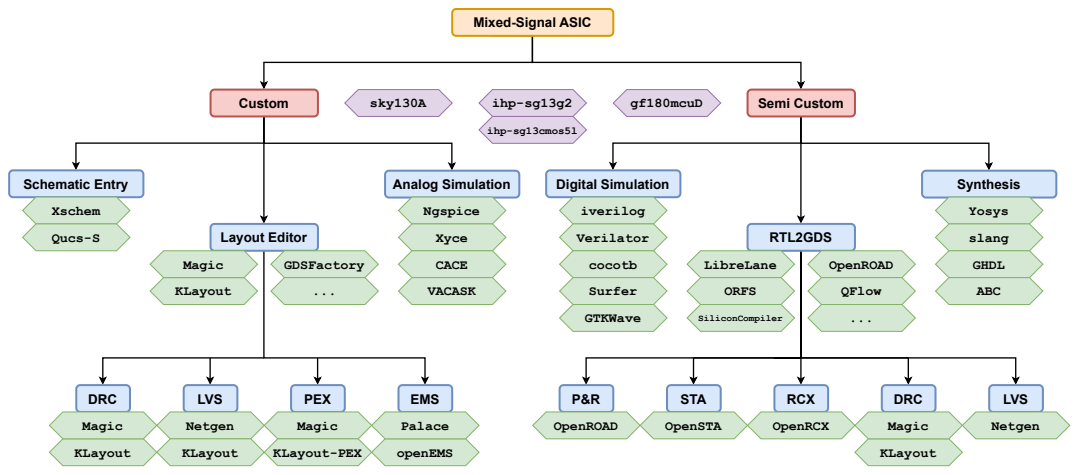
[picture p83: page 1]
Custom; Semi Custom; Schematic Entry; Analog Simulation; Layout Editor; DRC; LVS; PEX; Digital Simulation; RTL2GDS; STA; Synthesis; RCX; Xschem; Ngspice; Xyce; KLayout; Magic; iverilog; Verilator; Yosys; OpenROAD; Netgen; LibreLane; sky130A; Qucs-S; gf180mcuD; OpenSTA; OpenRCX; slang; GHDL; KLayout-PEX; GDSFactory; cocotb; Surfer; CACE; ORFS; ABC; GTKWave; SiliconCompiler; QFlow; ihp-sg13g2; VACASK; EMS; openEMS; Palace; ihp-sg13cmos5l

Mixed-Signal ASIC
