iic-jku/ihp-sg13g2-ams-chip-template/testbenches/xschem/plot_simulations/figures/chip_top_tb_tran_digital2.pdf

# Chip Top

# — Counter 2 Output Bits

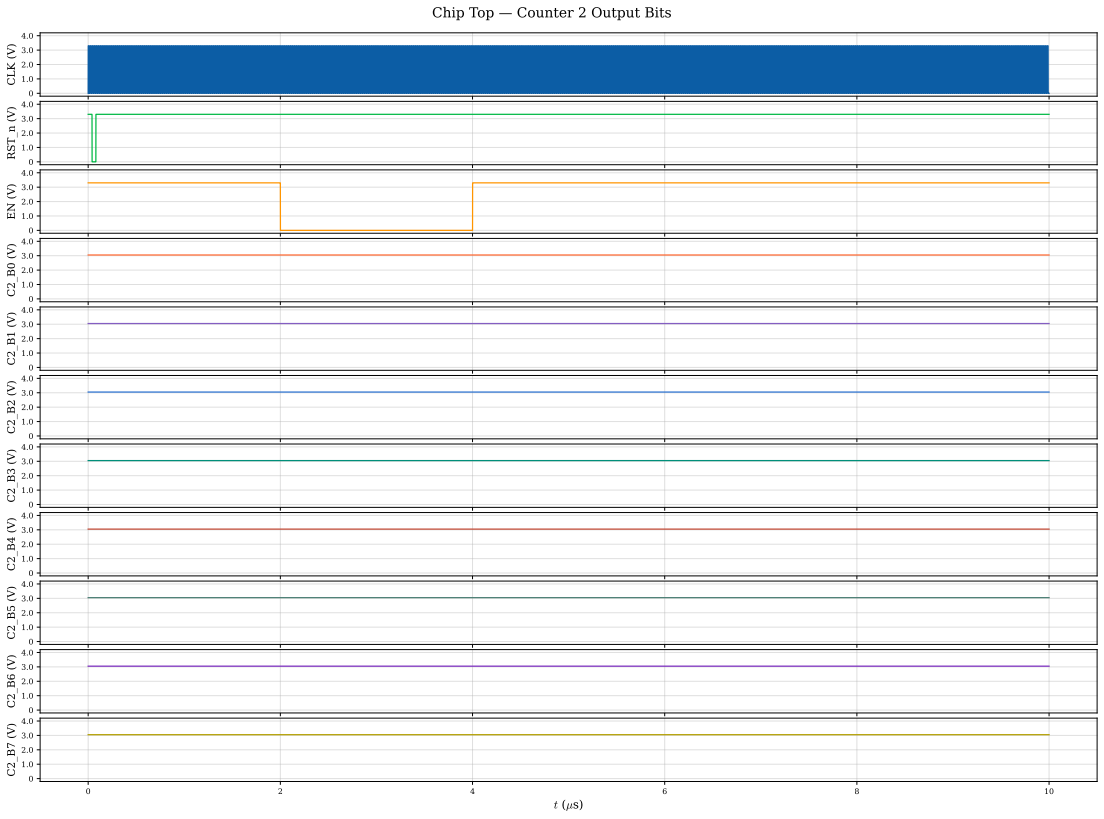
[picture p85: page 1]
CLK (V); RST_n (V)
