iic-jku/ihp-sg13g2-ams-chip-template/testbenches/xschem/plot_simulations/figures/chip_top_tb_tran_digital3.pdf

# Chip Top

# — Counter 1 / INV1 Inputs (Bits 4

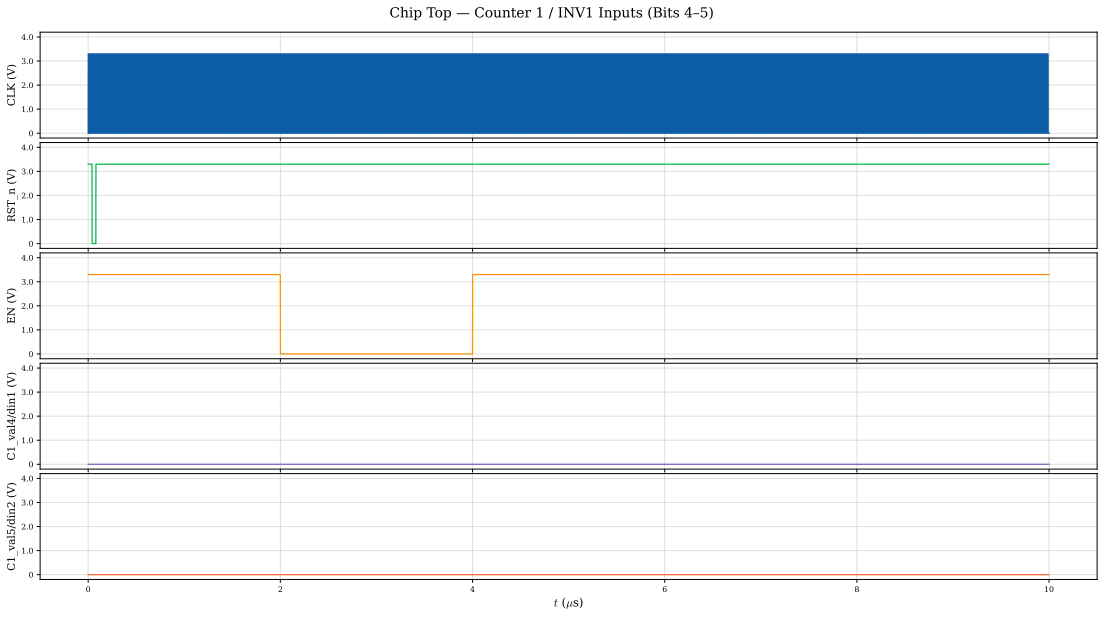
[picture p86: page 1]
CLK (V); RST_n (V); C1_val4/din1 (V); C1_val5/din2 (V)
