iic-jku/ihp-sg13g2-ams-chip-template/macros/counter/testbenches/xschem/plot_simulations/figures/counter_top_tb_tran.pdf

# Counter Top - Gate-Level Transient Simulation

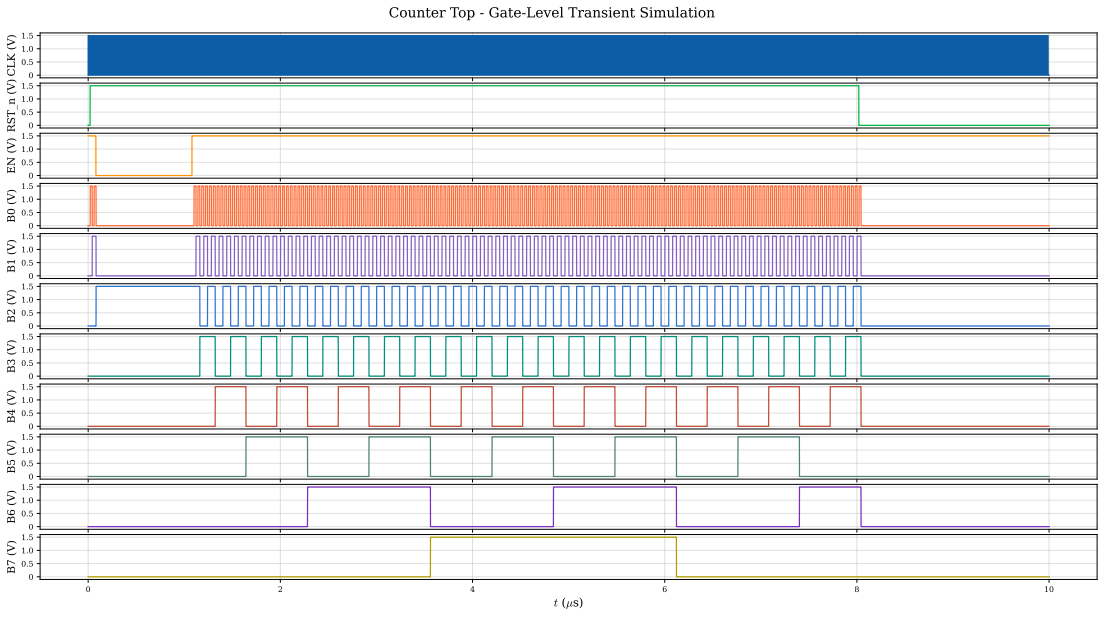
[picture p87: page 1]
CLK (V); RST_n (V)
