iic-jku/ihp-sg13g2-ams-chip-template/macros/inverter/testbenches/xschem/plot_simulations/figures/inverter_tb_dc_vout.pdf

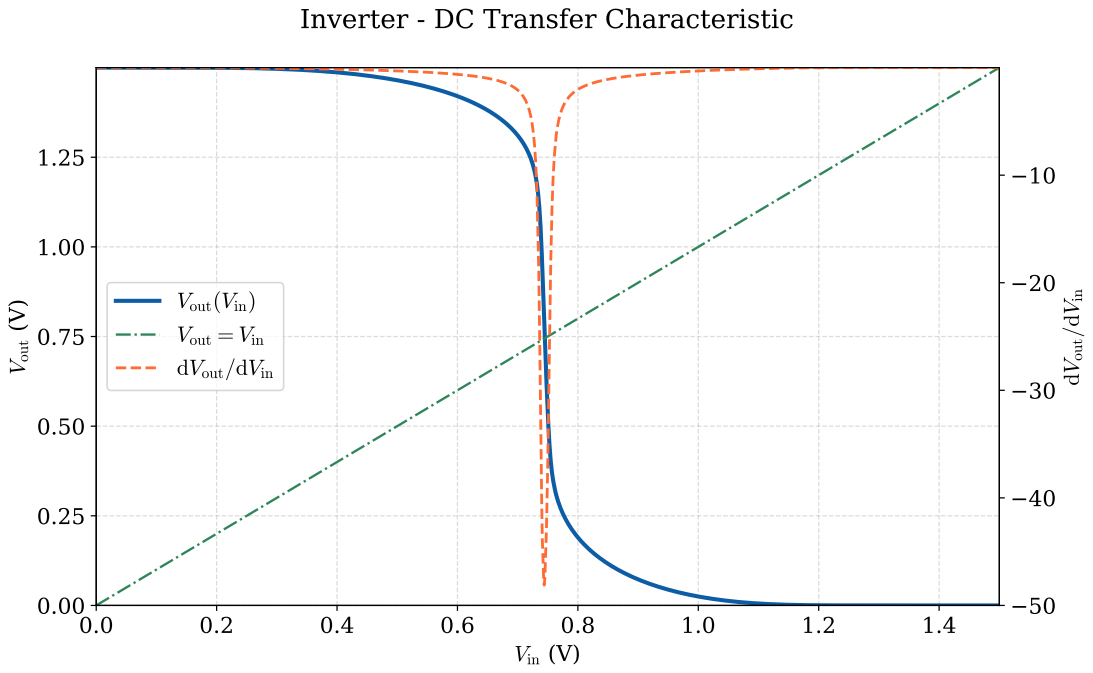
[picture p88: page 1]
Vin (V); Vout (V); Vout=; Vin

Inverter - DC Transfer Characteristic

Vout(Vin) Vout | = Vin

dVout=dVin
