iic-jku/ihp-sg13g2-ams-chip-template/macros/inverter/scripts/sizing/figures/inverter_circuit.pdf

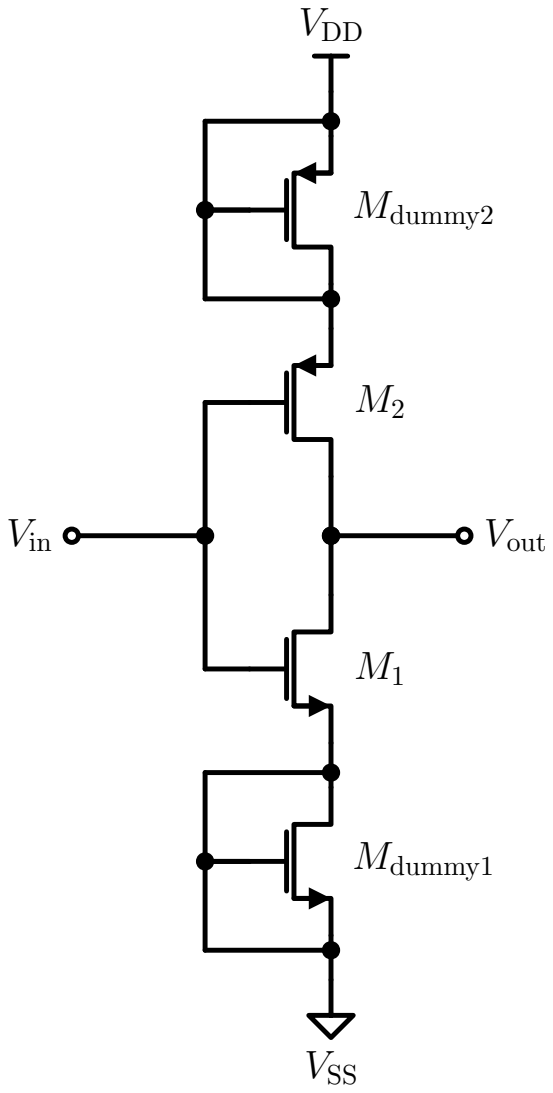
[picture p90: page 1]
Mdummy2; VDD; Mdummy1; VSS; Vin; Vout
