iic-jku/ihp-sg13g2-ams-chip-template/macros/inverter/netlist/pex/inverter_klayout_pex_3.spice

* NGSPICE file created from inverter_pex.ext - technology: ihp-sg13g2

.subckt inverter_pex VDD vin vout VSS
X0 VSS.t3 vin vout VSS.t13 sg13_lv_nmos ad=0.19p pd=1.38u as=0.19p ps=1.38u w=1u l=1u
X1 VSS.t27 VSS.t3 VSS.t22 VSS.t25 sg13_lv_nmos ad=0.19p pd=1.38u as=0 ps=0 w=1u l=1u
X2 vout vin VDD VDD sg13_lv_pmos ad=1.14p pd=6.38u as=1.14p ps=6.38u w=6u l=1u
X3 VDD vin vout VDD sg13_lv_pmos ad=1.14p pd=6.38u as=1.14p ps=6.38u w=6u l=1u
X4 vout vin VDD VDD sg13_lv_pmos ad=1.14p pd=6.38u as=1.14p ps=6.38u w=6u l=1u
X5 vout vin VSS.t3 VSS.t12 sg13_lv_nmos ad=0.19p pd=1.38u as=0.19p ps=1.38u w=1u l=1u
X6 vout vin VSS.t1 VSS.t0 sg13_lv_nmos ad=0.19p pd=1.38u as=0.19p ps=1.38u w=1u l=1u
X7 vout vin VDD VDD sg13_lv_pmos ad=1.14p pd=6.38u as=1.14p ps=6.38u w=6u l=1u
X8 VSS.t1 VSS.t3 VSS.t24 VSS.t23 sg13_lv_nmos ad=0.34p pd=2.68u as=0 ps=0 w=1u l=1u
X9 VSS.t3 vin vout VSS.t17 sg13_lv_nmos ad=0.19p pd=1.38u as=0.19p ps=1.38u w=1u l=1u
X10 vout vin VSS.t3 VSS.t16 sg13_lv_nmos ad=0.19p pd=1.38u as=0.19p ps=1.38u w=1u l=1u
X11 VDD vin vout VDD sg13_lv_pmos ad=1.14p pd=6.38u as=1.14p ps=6.38u w=6u l=1u
X12 vout vin VDD VDD sg13_lv_pmos ad=1.14p pd=6.38u as=1.14p ps=6.38u w=6u l=1u
X13 VSS.t3 vin vout VSS.t7 sg13_lv_nmos ad=0.19p pd=1.38u as=0.19p ps=1.38u w=1u l=1u
X14 VSS.t22 vin vout VSS.t21 sg13_lv_nmos ad=0.19p pd=1.38u as=0.19p ps=1.38u w=1u l=1u
X15 VDD vin vout VDD sg13_lv_pmos ad=1.14p pd=6.38u as=1.14p ps=6.38u w=6u l=1u
X16 vout vin VDD VDD sg13_lv_pmos ad=1.14p pd=6.38u as=1.14p ps=6.38u w=6u l=1u
X17 VDD vin vout VDD sg13_lv_pmos ad=1.14p pd=6.38u as=1.14p ps=6.38u w=6u l=1u
X18 vout vin VDD VDD sg13_lv_pmos ad=1.14p pd=6.38u as=1.14p ps=6.38u w=6u l=1u
X19 VSS.t3 vin vout VSS.t11 sg13_lv_nmos ad=0.19p pd=1.38u as=0.19p ps=1.38u w=1u l=1u
X20 vout vin VSS.t3 VSS.t20 sg13_lv_nmos ad=0.19p pd=1.38u as=0.19p ps=1.38u w=1u l=1u
X21 VDD vin vout VDD sg13_lv_pmos ad=1.14p pd=6.38u as=1.14p ps=6.38u w=6u l=1u
X22 vout vin VDD VDD sg13_lv_pmos ad=1.14p pd=6.38u as=1.14p ps=6.38u w=6u l=1u
X23 VDD VDD VDD VDD sg13_lv_pmos ad=2.04p pd=12.68u as=0.14199n ps=0.28418m w=6u l=1u
X24 vout vin VSS.t3 VSS.t6 sg13_lv_nmos ad=0.19p pd=1.38u as=0.19p ps=1.38u w=1u l=1u
X25 VSS.t3 vin vout VSS.t15 sg13_lv_nmos ad=0.19p pd=1.38u as=0.19p ps=1.38u w=1u l=1u
X26 VDD vin vout VDD sg13_lv_pmos ad=1.14p pd=6.38u as=1.14p ps=6.38u w=6u l=1u
X27 VDD vin vout VDD sg13_lv_pmos ad=1.14p pd=6.38u as=1.14p ps=6.38u w=6u l=1u
X28 VSS.t3 vin vout VSS.t5 sg13_lv_nmos ad=0.19p pd=1.38u as=0.19p ps=1.38u w=1u l=1u
X29 vout vin VDD VDD sg13_lv_pmos ad=1.14p pd=6.38u as=1.14p ps=6.38u w=6u l=1u
X30 VSS.t3 vin vout VSS.t19 sg13_lv_nmos ad=0.19p pd=1.38u as=0.19p ps=1.38u w=1u l=1u
X31 VSS.t3 vin vout VSS.t2 sg13_lv_nmos ad=0.19p pd=1.38u as=0.19p ps=1.38u w=1u l=1u
X32 vout vin VSS.t3 VSS.t10 sg13_lv_nmos ad=0.19p pd=1.38u as=0.19p ps=1.38u w=1u l=1u
X33 vout vin VSS.t3 VSS.t4 sg13_lv_nmos ad=0.19p pd=1.38u as=0.19p ps=1.38u w=1u l=1u
X34 vout vin VSS.t3 VSS.t18 sg13_lv_nmos ad=0.19p pd=1.38u as=0.19p ps=1.38u w=1u l=1u
X35 VDD vin vout VDD sg13_lv_pmos ad=1.14p pd=6.38u as=1.14p ps=6.38u w=6u l=1u
X36 vout vin VDD VDD sg13_lv_pmos ad=1.14p pd=6.38u as=1.14p ps=6.38u w=6u l=1u
X37 VSS.t3 vin vout VSS.t9 sg13_lv_nmos ad=0.19p pd=1.38u as=0.19p ps=1.38u w=1u l=1u
X38 VDD vin vout VDD sg13_lv_pmos ad=1.14p pd=6.38u as=1.14p ps=6.38u w=6u l=1u
X39 VDD VDD VDD VDD sg13_lv_pmos ad=1.14p pd=6.38u as=0 ps=0 w=6u l=1u
X40 vout vin VDD VDD sg13_lv_pmos ad=1.14p pd=6.38u as=1.14p ps=6.38u w=6u l=1u
X41 VDD vin vout VDD sg13_lv_pmos ad=1.14p pd=6.38u as=1.14p ps=6.38u w=6u l=1u
X42 vout vin VSS.t3 VSS.t8 sg13_lv_nmos ad=0.19p pd=1.38u as=0.19p ps=1.38u w=1u l=1u
X43 vout vin VSS.t3 VSS.t14 sg13_lv_nmos ad=0.19p pd=1.38u as=0.19p ps=1.38u w=1u l=1u
C0 VDD vout 8.86472f
C1 vin vout 15.6916f
C2 vin VDD 25.795f
R0 VSS.t19 VSS.t3 33.0469
R1 VSS.t18 VSS.t3 39.0515
R2 VSS.t17 VSS.t3 43.8551
R3 VSS.t14 VSS.t3 51.0604
R4 VSS.t13 VSS.t3 51.0603
R5 VSS.t3 VSS.t11 49.8531
R6 VSS.t25 VSS.t3 7.82756
R7 VSS.t3 VSS.t5 39.0517
R8 VSS.t15 VSS.t3 49.86
R9 VSS.t16 VSS.t3 47.4577
R10 VSS.t12 VSS.t3 49.8715
R11 VSS.t10 VSS.t3 51.0606
R12 VSS.t6 VSS.t3 43.8554
R13 VSS.t2 VSS.t3 25.8412
R14 VSS.t3 VSS.t22 5.74916
R15 VSS.t1 VSS.t3 5.668
R16 VSS.t3 VSS.t24 5.66889
R17 VSS.t3 VSS.t7 47.4576
R18 VSS.t3 VSS.t8 49.8595
R19 VSS.t3 VSS.t20 25.8412
R20 VSS.t3 VSS.t21 17.4341
R21 VSS.t0 VSS.t3 17.4345
R22 VSS.t4 VSS.t3 33.0466
R23 VSS.t9 VSS.t3 51.0606
R24 VSS.t23 VSS.t3 7.8261
R25 VSS.t27 VSS.t3 6.36562
R26 VSS VSS.t3 0.0005
C3 vout VSS 2.95976f
C4 vin VSS 12.6327f
C5 VDD VSS 2.98893f
.ends
