iic-jku/ihp-sg13g2-ams-chip-template/macros/inverter/netlist/pex/inverter_magic_pex_3.spice

* PEX produced on Wed Aug 26 09:49:24 AM CEST 2026 using /foss/tools/sak/sak-pex.sh with m=3 and s=1 (extresist threshold=10000 mOhm, minres=1000 mOhm, mindelay=1 ps)
* NGSPICE file created from inverter_pex.ext - technology: ihp-sg13g2

.subckt inverter_pex VDD vin vout VSS
X0 VSS vin vout VSS.t12 sg13_lv_nmos ad=0.19p pd=1.38u as=0.19p ps=1.38u w=1u l=1u
X1 VSS.t27 VSS.t25 VSS.t21 VSS.t26 sg13_lv_nmos ad=0.19p pd=1.38u as=0 ps=0 w=1u l=1u
X2 vout vin VDD VDD sg13_lv_pmos ad=1.14p pd=6.38u as=1.14p ps=6.38u w=6u l=1u
X3 VDD vin vout VDD sg13_lv_pmos ad=1.14p pd=6.38u as=1.14p ps=6.38u w=6u l=1u
X4 vout vin VDD VDD sg13_lv_pmos ad=1.14p pd=6.38u as=1.14p ps=6.38u w=6u l=1u
X5 vout vin VSS VSS.t11 sg13_lv_nmos ad=0.19p pd=1.38u as=0.19p ps=1.38u w=1u l=1u
X6 vout vin VSS.t1 VSS.t0 sg13_lv_nmos ad=0.19p pd=1.38u as=0.19p ps=1.38u w=1u l=1u
X7 vout vin VDD VDD sg13_lv_pmos ad=1.14p pd=6.38u as=1.14p ps=6.38u w=6u l=1u
X8 VSS.t1 VSS.t22 VSS.t24 VSS.t23 sg13_lv_nmos ad=0.34p pd=2.68u as=0 ps=0 w=1u l=1u
X9 VSS vin vout VSS.t16 sg13_lv_nmos ad=0.19p pd=1.38u as=0.19p ps=1.38u w=1u l=1u
X10 vout vin VSS VSS.t15 sg13_lv_nmos ad=0.19p pd=1.38u as=0.19p ps=1.38u w=1u l=1u
X11 VDD vin vout VDD sg13_lv_pmos ad=1.14p pd=6.38u as=1.14p ps=6.38u w=6u l=1u
X12 vout vin VDD VDD sg13_lv_pmos ad=1.14p pd=6.38u as=1.14p ps=6.38u w=6u l=1u
X13 VSS vin vout VSS.t6 sg13_lv_nmos ad=0.19p pd=1.38u as=0.19p ps=1.38u w=1u l=1u
X14 VSS.t21 vin vout VSS.t20 sg13_lv_nmos ad=0.19p pd=1.38u as=0.19p ps=1.38u w=1u l=1u
X15 VDD vin vout VDD sg13_lv_pmos ad=1.14p pd=6.38u as=1.14p ps=6.38u w=6u l=1u
X16 vout vin VDD VDD sg13_lv_pmos ad=1.14p pd=6.38u as=1.14p ps=6.38u w=6u l=1u
X17 VDD vin vout VDD sg13_lv_pmos ad=1.14p pd=6.38u as=1.14p ps=6.38u w=6u l=1u
X18 vout vin VDD VDD sg13_lv_pmos ad=1.14p pd=6.38u as=1.14p ps=6.38u w=6u l=1u
X19 VSS vin vout VSS.t10 sg13_lv_nmos ad=0.19p pd=1.38u as=0.19p ps=1.38u w=1u l=1u
X20 vout vin VSS VSS.t19 sg13_lv_nmos ad=0.19p pd=1.38u as=0.19p ps=1.38u w=1u l=1u
X21 VDD vin vout VDD sg13_lv_pmos ad=1.14p pd=6.38u as=1.14p ps=6.38u w=6u l=1u
X22 vout vin VDD VDD sg13_lv_pmos ad=1.14p pd=6.38u as=1.14p ps=6.38u w=6u l=1u
X23 VDD VDD VDD VDD sg13_lv_pmos ad=2.04p pd=12.68u as=0.14199n ps=0.28418m w=6u l=1u
X24 vout vin VSS VSS.t5 sg13_lv_nmos ad=0.19p pd=1.38u as=0.19p ps=1.38u w=1u l=1u
X25 VSS vin vout VSS.t14 sg13_lv_nmos ad=0.19p pd=1.38u as=0.19p ps=1.38u w=1u l=1u
X26 VDD vin vout VDD sg13_lv_pmos ad=1.14p pd=6.38u as=1.14p ps=6.38u w=6u l=1u
X27 VDD vin vout VDD sg13_lv_pmos ad=1.14p pd=6.38u as=1.14p ps=6.38u w=6u l=1u
X28 VSS vin vout VSS.t4 sg13_lv_nmos ad=0.19p pd=1.38u as=0.19p ps=1.38u w=1u l=1u
X29 vout vin VDD VDD sg13_lv_pmos ad=1.14p pd=6.38u as=1.14p ps=6.38u w=6u l=1u
X30 VSS vin vout VSS.t18 sg13_lv_nmos ad=0.19p pd=1.38u as=0.19p ps=1.38u w=1u l=1u
X31 VSS vin vout VSS.t2 sg13_lv_nmos ad=0.19p pd=1.38u as=0.19p ps=1.38u w=1u l=1u
X32 vout vin VSS VSS.t9 sg13_lv_nmos ad=0.19p pd=1.38u as=0.19p ps=1.38u w=1u l=1u
X33 vout vin VSS VSS.t3 sg13_lv_nmos ad=0.19p pd=1.38u as=0.19p ps=1.38u w=1u l=1u
X34 vout vin VSS VSS.t17 sg13_lv_nmos ad=0.19p pd=1.38u as=0.19p ps=1.38u w=1u l=1u
X35 VDD vin vout VDD sg13_lv_pmos ad=1.14p pd=6.38u as=1.14p ps=6.38u w=6u l=1u
X36 vout vin VDD VDD sg13_lv_pmos ad=1.14p pd=6.38u as=1.14p ps=6.38u w=6u l=1u
X37 VSS vin vout VSS.t8 sg13_lv_nmos ad=0.19p pd=1.38u as=0.19p ps=1.38u w=1u l=1u
X38 VDD vin vout VDD sg13_lv_pmos ad=1.14p pd=6.38u as=1.14p ps=6.38u w=6u l=1u
X39 VDD VDD VDD VDD sg13_lv_pmos ad=1.14p pd=6.38u as=0 ps=0 w=6u l=1u
X40 vout vin VDD VDD sg13_lv_pmos ad=1.14p pd=6.38u as=1.14p ps=6.38u w=6u l=1u
X41 VDD vin vout VDD sg13_lv_pmos ad=1.14p pd=6.38u as=1.14p ps=6.38u w=6u l=1u
X42 vout vin VSS VSS.t7 sg13_lv_nmos ad=0.19p pd=1.38u as=0.19p ps=1.38u w=1u l=1u
X43 vout vin VSS VSS.t13 sg13_lv_nmos ad=0.19p pd=1.38u as=0.19p ps=1.38u w=1u l=1u
R0 VSS VSS.t19 25.8408
R1 VSS VSS.t18 33.0473
R2 VSS VSS.t15 47.4578
R3 VSS VSS.t10 49.8593
R4 VSS VSS.t13 51.0616
R5 VSS.t7 VSS 49.8599
R6 VSS.t26 VSS 7.82754
R7 VSS VSS.t17 39.0515
R8 VSS VSS.t12 51.0605
R9 VSS VSS.t11 49.8592
R10 VSS.t9 VSS 51.0607
R11 VSS.t8 VSS 51.0614
R12 VSS.t6 VSS 47.4576
R13 VSS VSS.t3 33.0473
R14 VSS.t2 VSS 25.8412
R15 VSS.t27 VSS.t25 5.66439
R16 VSS.t25 VSS.t21 5.6636
R17 VSS.t20 VSS 17.4347
R18 VSS.t1 VSS.t22 5.66439
R19 VSS.t22 VSS.t24 5.6636
R20 VSS VSS.t23 7.82586
R21 VSS.t14 VSS 49.8596
R22 VSS.t0 VSS 17.4347
R23 VSS VSS.t4 39.0513
R24 VSS VSS.t16 43.8554
R25 VSS VSS.t22 1.21296
R26 VSS.t25 VSS 1.21296
R27 VSS.t5 VSS 43.8555
R28 VSS VSS.t25 1.69868
R29 VSS VSS.t22 1.17168
C0 vin VDD 25.795f
C1 vout VDD 8.86472f
C2 vout vin 15.6916f
C3 vout VSS 9.27611f
.ends
