iic-jku/ihp-sg13g2-ams-chip-template/macros/inverter/netlist/pex/inverter_top_klayout_pex_3.spice

* NGSPICE file created from inverter_top_pex.ext - technology: ihp-sg13g2

.subckt inverter_top_pex VDD vin4 vout4 VSS vin3 vout3 vin2 vout2 vout1 vin1
X0 vout3 vin3 VSS.t102 VSS.t83 sg13_lv_nmos ad=0.19p pd=1.38u as=0.19p ps=1.38u w=1u l=1u
X1 VDD VDD VDD VDD sg13_lv_pmos ad=1.14p pd=6.38u as=0.56797n ps=1.006m w=6u l=1u
X2 VSS.t1 VSS.t50 VSS.t52 VSS.t51 sg13_lv_nmos ad=0.34p pd=2.68u as=0 ps=0 w=1u l=1u
X3 VDD VDD VDD VDD sg13_lv_pmos ad=1.14p pd=6.38u as=0 ps=0 w=6u l=1u
X4 VDD vin4 vout4 VDD sg13_lv_pmos ad=1.14p pd=6.38u as=1.14p ps=6.38u w=6u l=1u
X5 vout2 vin2 VSS.t73 VSS.t74 sg13_lv_nmos ad=0.19p pd=1.38u as=0.19p ps=1.38u w=1u l=1u
X6 vout3 vin3 VDD VDD sg13_lv_pmos ad=1.14p pd=6.38u as=1.14p ps=6.38u w=6u l=1u
X7 vout4 vin4 VSS.t107 VSS.t108 sg13_lv_nmos ad=0.19p pd=1.38u as=0.19p ps=1.38u w=1u l=1u
X8 vout3 vin3 VSS.t41 VSS.t56 sg13_lv_nmos ad=0.19p pd=1.38u as=0.19p ps=1.38u w=1u l=1u
X9 vout2 vin2 VSS.t67 VSS.t68 sg13_lv_nmos ad=0.19p pd=1.38u as=0.19p ps=1.38u w=1u l=1u
X10 vout4 vin4 VDD VDD sg13_lv_pmos ad=1.14p pd=6.38u as=1.14p ps=6.38u w=6u l=1u
X11 VDD vin2 vout2 VDD sg13_lv_pmos ad=1.14p pd=6.38u as=1.14p ps=6.38u w=6u l=1u
X12 VSS.t73 vin2 vout2 VSS.t72 sg13_lv_nmos ad=0.19p pd=1.38u as=0.19p ps=1.38u w=1u l=1u
X13 vout2 vin2 VSS.t76 VSS.t77 sg13_lv_nmos ad=0.19p pd=1.38u as=0.19p ps=1.38u w=1u l=1u
X14 vout2 vin2 VDD VDD sg13_lv_pmos ad=1.14p pd=6.38u as=1.14p ps=6.38u w=6u l=1u
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
R469 VSS.n110 VSS.n70 0.0863543
R470 VSS.n125 VSS.n124 0.085919
R471 VSS.n89 VSS.n86 0.0854405
R472 VSS.n82 VSS.n81 0.0852323
R473 VSS.n84 VSS.n83 0.0852323
R474 VSS.n30 VSS.t53 0.0849321
R475 VSS.t50 VSS.n71 0.0840328
R476 VSS.n113 VSS.n112 0.0840349
R477 VSS.n123 VSS.n122 0.0836579
R478 VSS.n118 VSS.t31 0.0834709
R479 VSS.n88 VSS.n87 0.082996
R480 VSS.n80 VSS.n79 0.0827878
R481 VSS.t35 VSS.n117 0.0823232
R482 VSS.n121 VSS.n120 0.0814717
R483 VSS.n115 VSS.n114 0.0813395
R484 VSS.n78 VSS.n77 0.0803434
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
