iic-jku/ihp-sg13g2-ams-chip-template/macros/inverter/netlist/pex/inverter_top_magic_pex_3.spice

* PEX produced on Wed Aug 26 09:49:27 AM CEST 2026 using /foss/tools/sak/sak-pex.sh with m=3 and s=1 (extresist threshold=10000 mOhm, minres=1000 mOhm, mindelay=1 ps)
* NGSPICE file created from inverter_top_pex.ext - technology: ihp-sg13g2

.subckt inverter_top_pex VDD vin4 vout4 VSS vin3 vout3 vin2 vout2 vout1 vin1
X0 vout3 vin3 VSS.t105 VSS.t86 sg13_lv_nmos ad=0.19p pd=1.38u as=0.19p ps=1.38u w=1u l=1u
X1 VDD VDD VDD VDD sg13_lv_pmos ad=1.14p pd=6.38u as=0.56797n ps=1.006m w=6u l=1u
X2 VSS.t1 VSS.t53 VSS.t55 VSS.t54 sg13_lv_nmos ad=0.34p pd=2.68u as=0 ps=0 w=1u l=1u
X3 VDD VDD VDD VDD sg13_lv_pmos ad=1.14p pd=6.38u as=0 ps=0 w=6u l=1u
X4 VDD vin4 vout4 VDD sg13_lv_pmos ad=1.14p pd=6.38u as=1.14p ps=6.38u w=6u l=1u
X5 vout2 vin2 VSS.t76 VSS.t77 sg13_lv_nmos ad=0.19p pd=1.38u as=0.19p ps=1.38u w=1u l=1u
X6 vout3 vin3 VDD VDD sg13_lv_pmos ad=1.14p pd=6.38u as=1.14p ps=6.38u w=6u l=1u
X7 vout4 vin4 VSS.t110 VSS.t111 sg13_lv_nmos ad=0.19p pd=1.38u as=0.19p ps=1.38u w=1u l=1u
X8 vout3 vin3 VSS.t42 VSS.t59 sg13_lv_nmos ad=0.19p pd=1.38u as=0.19p ps=1.38u w=1u l=1u
X9 vout2 vin2 VSS.t70 VSS.t71 sg13_lv_nmos ad=0.19p pd=1.38u as=0.19p ps=1.38u w=1u l=1u
X10 vout4 vin4 VDD VDD sg13_lv_pmos ad=1.14p pd=6.38u as=1.14p ps=6.38u w=6u l=1u
X11 VDD vin2 vout2 VDD sg13_lv_pmos ad=1.14p pd=6.38u as=1.14p ps=6.38u w=6u l=1u
X12 VSS.t76 vin2 vout2 VSS.t75 sg13_lv_nmos ad=0.19p pd=1.38u as=0.19p ps=1.38u w=1u l=1u
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
R481 VSS.n270 VSS.n160 7.20236
R482 VSS.n163 VSS.n88 7.20236
R483 VSS.n265 VSS.n264 7.20236
R484 VSS.n259 VSS.n166 7.20236
R485 VSS.n172 VSS.n87 7.20236
R486 VSS.n258 VSS.n257 7.20236
R487 VSS.n176 VSS.n86 7.20236
R488 VSS.n254 VSS.n73 7.20236
R489 VSS.n251 VSS.n182 7.20236
R490 VSS.n187 VSS.n186 7.20236
R491 VSS.n245 VSS.n74 7.20236
R492 VSS.n188 VSS.n84 7.20236
R493 VSS.n242 VSS.n241 7.20236
R494 VSS.n237 VSS.n190 7.20236
R495 VSS.n193 VSS.n192 7.20236
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
