iic-jku/ihp-sg13g2-ams-chip-template/macros/counter/netlist/spice/counter_top.spice

* NGSPICE file created from counter_top.ext - technology: ihp-sg13g2

* Black-box entry subcircuit for sg13g2_decap_8 abstract view
.subckt sg13g2_decap_8 VDD VSS
.ends

* Black-box entry subcircuit for sg13g2_dfrbpq_1 abstract view
.subckt sg13g2_dfrbpq_1 Q CLK D RESET_B VDD VSS
.ends

* Black-box entry subcircuit for sg13g2_a21oi_1 abstract view
.subckt sg13g2_a21oi_1 Y A1 A2 B1 VDD VSS
.ends

* Black-box entry subcircuit for sg13g2_dlygate4sd3_1 abstract view
.subckt sg13g2_dlygate4sd3_1 X A VDD VSS
.ends

* Black-box entry subcircuit for sg13g2_fill_1 abstract view
.subckt sg13g2_fill_1 VDD VSS
.ends

* Black-box entry subcircuit for sg13g2_buf_1 abstract view
.subckt sg13g2_buf_1 X A VDD VSS
.ends

* Black-box entry subcircuit for sg13g2_and2_1 abstract view
.subckt sg13g2_and2_1 X A B VDD VSS
.ends

* Black-box entry subcircuit for sg13g2_or3_1 abstract view
.subckt sg13g2_or3_1 X A B C VDD VSS
.ends

* Black-box entry subcircuit for sg13g2_fill_2 abstract view
.subckt sg13g2_fill_2 VDD VSS
.ends

* Black-box entry subcircuit for sg13g2_xnor2_1 abstract view
.subckt sg13g2_xnor2_1 Y A B VDD VSS
.ends

* Black-box entry subcircuit for sg13g2_o21ai_1 abstract view
.subckt sg13g2_o21ai_1 Y A1 A2 B1 VDD VSS
.ends

* Black-box entry subcircuit for sg13g2_nand3_1 abstract view
.subckt sg13g2_nand3_1 Y A B C VDD VSS
.ends

* Black-box entry subcircuit for sg13g2_nand2_1 abstract view
.subckt sg13g2_nand2_1 Y A B VDD VSS
.ends

* Black-box entry subcircuit for sg13g2_decap_4 abstract view
.subckt sg13g2_decap_4 VDD VSS
.ends

* Black-box entry subcircuit for sg13g2_tiehi abstract view
.subckt sg13g2_tiehi L_HI VDD VSS
.ends

* Black-box entry subcircuit for sg13g2_nor2_1 abstract view
.subckt sg13g2_nor2_1 Y A B VDD VSS
.ends

* Black-box entry subcircuit for sg13g2_buf_4 abstract view
.subckt sg13g2_buf_4 X A VDD VSS
.ends

* Black-box entry subcircuit for sg13g2_buf_16 abstract view
.subckt sg13g2_buf_16 X A VDD VSS
.ends

* Black-box entry subcircuit for sg13g2_xor2_1 abstract view
.subckt sg13g2_xor2_1 X A B VDD VSS
.ends

* Black-box entry subcircuit for sg13g2_nand4_1 abstract view
.subckt sg13g2_nand4_1 Y A B C D VDD VSS
.ends

* Black-box entry subcircuit for sg13g2_inv_1 abstract view
.subckt sg13g2_inv_1 Y A VDD VSS
.ends

.subckt counter_top VDD VSS clock_i counter_value_o[0] counter_value_o[1] counter_value_o[2]
+ counter_value_o[3] counter_value_o[4] counter_value_o[5] counter_value_o[6] counter_value_o[7]
+ enable_i reset_n_i
XFILLER_7_7 VDD VSS sg13g2_decap_8
XFILLER_13_133 VDD VSS sg13g2_decap_8
XFILLER_9_137 VDD VSS sg13g2_decap_8
XFILLER_3_56 VDD VSS sg13g2_decap_8
XFILLER_5_343 VDD VSS sg13g2_decap_8
XFILLER_12_98 VDD VSS sg13g2_decap_8
XFILLER_12_21 VDD VSS sg13g2_decap_8
XFILLER_10_147 VDD VSS sg13g2_decap_8
XFILLER_2_357 VDD VSS sg13g2_decap_8
XFILLER_17_291 VDD VSS sg13g2_decap_8
X_66_ _66_/Q _73_/CLK _66_/D _66__18/L_HI VDD VSS sg13g2_dfrbpq_1
XFILLER_5_140 VDD VSS sg13g2_decap_8
XFILLER_9_88 VDD VSS sg13g2_decap_8
XFILLER_9_11 VDD VSS sg13g2_decap_8
XFILLER_0_35 VDD VSS sg13g2_decap_8
XFILLER_2_154 VDD VSS sg13g2_decap_8
X_49_ _49_/Y _49_/A1 _48_/X _42_/A VDD VSS sg13g2_a21oi_1
XFILLER_11_231 VDD VSS sg13g2_decap_8
XFILLER_7_224 VDD VSS sg13g2_decap_8
XFILLER_16_345 VDD VSS sg13g2_decap_8
Xhold30 _45_/A1 _43_/Y VDD VSS sg13g2_dlygate4sd3_1
XFILLER_4_238 VDD VSS sg13g2_decap_8
XFILLER_6_56 VDD VSS sg13g2_decap_8
XFILLER_15_87 VDD VSS sg13g2_fill_1
XFILLER_15_21 VDD VSS sg13g2_decap_8
XFILLER_13_359 VDD VSS sg13g2_decap_8
XFILLER_9_319 VDD VSS sg13g2_decap_8
Xoutput7 counter_value_o[4] _73_/Q VDD VSS sg13g2_buf_1
XFILLER_8_385 VDD VSS sg13g2_decap_8
XFILLER_0_252 VDD VSS sg13g2_decap_8
XFILLER_11_0 VDD VSS sg13g2_decap_8
XFILLER_10_329 VDD VSS sg13g2_decap_8
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
XFILLER_10_371 VDD VSS sg13g2_decap_8
XFILLER_6_364 VDD VSS sg13g2_decap_8
XFILLER_11_168 VDD VSS sg13g2_decap_8
XFILLER_8_77 VDD VSS sg13g2_decap_8
XFILLER_3_301 VDD VSS sg13g2_decap_8
XFILLER_3_378 VDD VSS sg13g2_decap_8
XFILLER_6_161 VDD VSS sg13g2_decap_8
XFILLER_0_315 VDD VSS sg13g2_decap_8
XFILLER_17_97 VDD VSS sg13g2_decap_8
XFILLER_17_31 VDD VSS sg13g2_decap_8
XFILLER_3_175 VDD VSS sg13g2_decap_8
XFILLER_15_282 VDD VSS sg13g2_decap_8
XFILLER_12_7 VDD VSS sg13g2_decap_8
XFILLER_0_189 VDD VSS sg13g2_decap_8
XFILLER_0_112 VDD VSS sg13g2_decap_8
XFILLER_12_252 VDD VSS sg13g2_decap_8
XFILLER_8_245 VDD VSS sg13g2_decap_8
XFILLER_5_56 VDD VSS sg13g2_decap_8
XFILLER_14_21 VDD VSS sg13g2_decap_8
XFILLER_17_388 VDD VSS sg13g2_decap_4
XFILLER_14_98 VDD VSS sg13g2_decap_8
XFILLER_5_259 VDD VSS sg13g2_decap_8
XFILLER_14_347 VDD VSS sg13g2_decap_8
XFILLER_17_196 VDD VSS sg13g2_decap_8
X_51_ _51_/Y _52_/B _52_/C _54_/A VDD VSS sg13g2_o21ai_1
XFILLER_13_391 VDD VSS sg13g2_fill_1
XFILLER_13_380 VDD VSS sg13g2_decap_8
XFILLER_9_340 VDD VSS sg13g2_decap_8
XFILLER_1_284 VDD VSS sg13g2_decap_8
XFILLER_2_35 VDD VSS sg13g2_decap_8
XFILLER_11_77 VDD VSS sg13g2_decap_8
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
