iic-jku/ihp-sg13g2-ams-chip-template/macros/inverter/netlist/pex/inverter_magic_pex.spice

* PEX produced on Tue May  5 10:26:57 PM CEST 2026 using /foss/tools/sak/sak-pex.sh with m=3 and s=1
* NGSPICE file created from inverter_pex.ext - technology: ihp-sg13g2

.subckt inverter_pex vin VSS VDD vout
X0 VSS.t24 vin.t0 vout.t10 VSS.t23 sg13_lv_nmos ad=0.19p pd=1.38u as=0.19p ps=1.38u w=1u l=1u
X1 VSS.t6 VSS.t4 VSS.t6 VSS.t5 sg13_lv_nmos ad=0.19p pd=1.38u as=0 ps=0 w=1u l=1u
X2 vout.t1 vin.t2 VDD.t17 VDD.t1 sg13_lv_pmos ad=1.14p pd=6.38u as=1.14p ps=6.38u w=6u l=1u
X3 VDD.t21 vin.t2 vout.t7 VDD.t1 sg13_lv_pmos ad=1.14p pd=6.38u as=1.14p ps=6.38u w=6u l=1u
X4 vout.t3 vin.t2 VDD.t23 VDD.t1 sg13_lv_pmos ad=1.14p pd=6.38u as=1.14p ps=6.38u w=6u l=1u
X5 vout.t10 vin.t0 VSS.t21 VSS.t22 sg13_lv_nmos ad=0.19p pd=1.38u as=0.19p ps=1.38u w=1u l=1u
X6 vout.t12 vin.t0 VSS.t2 VSS.t7 sg13_lv_nmos ad=0.19p pd=1.38u as=0.19p ps=1.38u w=1u l=1u
X7 VSS.t3 VSS.t0 VSS.t2 VSS.t1 sg13_lv_nmos ad=0.34p pd=2.68u as=0 ps=0 w=1u l=1u
X8 VSS.t30 vin.t0 vout.t18 VSS.t29 sg13_lv_nmos ad=0.19p pd=1.38u as=0.19p ps=1.38u w=1u l=1u
X9 vout.t4 vin.t2 VDD.t2 VDD.t1 sg13_lv_pmos ad=1.14p pd=6.38u as=1.14p ps=6.38u w=6u l=1u
X10 VDD.t19 vin.t2 vout.t1 VDD.t1 sg13_lv_pmos ad=1.14p pd=6.38u as=1.14p ps=6.38u w=6u l=1u
X11 vout.t18 vin.t0 VSS.t27 VSS.t28 sg13_lv_nmos ad=0.19p pd=1.38u as=0.19p ps=1.38u w=1u l=1u
X12 vout.t2 vin.t2 VDD.t21 VDD.t1 sg13_lv_pmos ad=1.14p pd=6.38u as=1.14p ps=6.38u w=6u l=1u
X13 VSS.t15 vin.t0 vout.t14 VSS.t14 sg13_lv_nmos ad=0.19p pd=1.38u as=0.19p ps=1.38u w=1u l=1u
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
C169 vout.t6 VSS 0.8539f
C170 vout.t15 VSS 0.12026f
C171 vout.t5 VSS 0.8539f
C172 vout.t16 VSS 0.12026f
C173 vout.t9 VSS 0.8539f
C174 vout.t14 VSS 0.12026f
C175 vout.t8 VSS 0.8539f
C176 vout.t13 VSS 0.12026f
C177 vout.t4 VSS 0.85424f
C178 vout.t12 VSS 0.12026f
C179 vout.n0 VSS 2.19847f
C180 vout.n1 VSS 2.38171f
C181 vout.n2 VSS 2.38171f
C182 vout.n3 VSS 2.38171f
C183 vout.n4 VSS 2.38171f
C184 vout.n5 VSS 2.37474f
C185 vout.n6 VSS 2.37474f
C186 vout.n7 VSS 2.37474f
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
