iic-jku/ihp-sg13g2-ams-chip-template/macros/inverter/netlist/pex/inverter_top_magic_pex.spice

* PEX produced on Tue May  5 10:27:07 PM CEST 2026 using /foss/tools/sak/sak-pex.sh with m=3 and s=1
* NGSPICE file created from inverter_top_pex.ext - technology: ihp-sg13g2

.subckt inverter_top_pex VDD vin4 vout4 VSS vin3 vout3 vin2 vout2 vout1 vin1
X0 VDD.t16 vin4.t0 vout4.t5 VDD.t0 sg13_lv_pmos ad=1.14p pd=6.38u as=1.14p ps=6.38u w=6u l=1u
X1 VDD.t41 VDD.t95 VDD.t41 VDD.t21 sg13_lv_pmos ad=1.14p pd=6.38u as=0 ps=0 w=6u l=1u
X2 vout2.t11 vin2.t2 VSS.t72 VSS.t73 sg13_lv_nmos ad=0.19p pd=1.38u as=0.19p ps=1.38u w=1u l=1u
X3 vout3.t15 vin3.t2 VDD.t65 VDD.t0 sg13_lv_pmos ad=1.14p pd=6.38u as=1.14p ps=6.38u w=6u l=1u
X4 vout3.t2 vin3.t0 VSS.t38 VSS.t55 sg13_lv_nmos ad=0.19p pd=1.38u as=0.19p ps=1.38u w=1u l=1u
X5 vout2.t14 vin2.t2 VSS.t66 VSS.t67 sg13_lv_nmos ad=0.19p pd=1.38u as=0.19p ps=1.38u w=1u l=1u
X6 vout4.t18 vin4.t2 VSS.t3 VSS.t4 sg13_lv_nmos ad=0.19p pd=1.38u as=0.19p ps=1.38u w=1u l=1u
X7 VDD.t41 vin2.t0 vout2.t3 VDD.t21 sg13_lv_pmos ad=1.14p pd=6.38u as=1.14p ps=6.38u w=6u l=1u
X8 vout4.t8 vin4.t0 VDD.t18 VDD.t0 sg13_lv_pmos ad=1.14p pd=6.38u as=1.14p ps=6.38u w=6u l=1u
X9 VSS.t72 vin2.t2 vout2.t19 VSS.t71 sg13_lv_nmos ad=0.19p pd=1.38u as=0.19p ps=1.38u w=1u l=1u
X10 vout2.t12 vin2.t2 VSS.t75 VSS.t76 sg13_lv_nmos ad=0.19p pd=1.38u as=0.19p ps=1.38u w=1u l=1u
X11 VSS.t9 vin4.t2 vout4.t10 VSS.t8 sg13_lv_nmos ad=0.19p pd=1.38u as=0.19p ps=1.38u w=1u l=1u
X12 vout1.t15 vin1.t0 VSS.t107 VSS.t108 sg13_lv_nmos ad=0.19p pd=1.38u as=0.19p ps=1.38u w=1u l=1u
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
R292 vin4.n26 vin4.n2 0.254024
R293 vin4.n27 vin4.n1 0.254024
R294 vin4.n9 vin4.n2 0.254024
R295 vin4.n10 vin4.n3 0.254024
R296 vin4.n11 vin4.n4 0.254024
R297 vin4.n12 vin4.n5 0.254024
R298 vin4.n13 vin4.n6 0.254024
R299 vin4.n14 vin4.n7 0.254024
R300 vin4.n15 vin4.n8 0.254024
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
