iic-jku/ihp-sg13g2-ams-chip-template/macros/counter/rtl/counter_top.sv

// SPDX-FileCopyrightText: 2026 Simon Dorrer and Harald Pretl
// SPDX-License-Identifier: Apache-2.0 WITH SHL-2.1
// Description: This file implements the top-level wrapper module
// of the counter macro in SystemVerilog.

`default_nettype none
`ifndef __COUNTER_TOP__
`define __COUNTER_TOP__

module counter_top #(
  parameter  int unsigned CTR_MAX = `COUNTER_MAX_DEFAULT,
  localparam int unsigned CTR_BW  = $clog2(CTR_MAX + 1)
)(
  input logic               clock_i,
  input logic               reset_n_i,
  input logic               enable_i,

  output logic [CTR_BW-1:0] counter_value_o
);

  // Internal active-high reset (wrapper handles polarity conversion)
  logic reset;
  assign reset = ~reset_n_i;

  // Embed Counter
  counter #(
    .CTR_BW(CTR_BW),
    .CTR_MAX(CTR_MAX)
  ) counter_0 (
    .clock_i(clock_i),
    .reset_i(reset),
    .enable_i(enable_i),
    .counter_value_o(counter_value_o)
  );
endmodule // counter_top

`endif
`default_nettype wire
