iic-jku/ihp-sg13g2-ams-chip-template/(commit log)

2026-05-04 added `testbenches` folder
    [chip_top_tb_tran.sch]
2026-05-04 added `schematic` folder
    [chip_top.sch]
2026-05-04 added `flow` folder
2026-05-04 added `macros/inverter` folder
    [inverter_tb_ac.csv, inverter_tb_ac.sch, inverter_top.sch, inverter_top_tb_ac_ol.sch, inverter_top_tb_tran.sch]
2026-05-04 added `macros/counter` folder
    [counter_top_tb_tran.sch, pin_order.cfg]
2026-05-04 updated `flow` folder (renamed riscv & iqmod to counter & inverter)
2026-05-04 updated `schematic` folder (renamed riscv & iqmod to counter & inverter)
    [chip_top.sch]
2026-05-04 updated `testbenches` folder (renamed riscv & iqmod to counter & inverter)
    [chip_top_tb_tran.sch]
2026-05-04 updated `macros/inverter` folder (renamed riscv & iqmod to counter & inverter)
    [inverter_top_tb_Vout.sch, inverter_top_tb_ac.csv, inverter_top_tb_ac.sch, inverter_top_tb_ac_ol.sch, inverter_top_tb_tran.sch]
2026-05-04 updated `macros/counter` folder (renamed riscv & iqmod to counter & inverter)
    [counter_top_tb_tran.sch]
2026-05-04 updated counter Xschem files
    [counter_top_tb_tran.sch]
2026-05-04 updated `chip_top_tb_tran.sch`
    [chip_top_tb_tran.sch]
2026-05-05 updated inverter Xschem files
    [inverter_top.sch, inverter_top_tb_Vout.sch, inverter_top_tb_ac_ol.sch, inverter_top_tb_tran.sch]
2026-05-05 added quad inverter (top)
    [inverter.sch, inverter_tb_Vout.sch, inverter_tb_ac_ol.sch, inverter_tb_tran.sch, inverter_top.sch, inverter_top_tb_tran.sch]
2026-05-05 added conditional labels to inverter schematics
    [inverter.sch, inverter_top.sch]
2026-05-05 ran inverter Makefile targets
    [inverter.sch]
2026-05-05 updated wrdata path in inverter testbenches
    [inverter_tb_Vout.sch, inverter_tb_ac_ol.sch, inverter_tb_tran.sch, inverter_top_tb_tran.sch]
2026-05-05 updated verilog target, `magic-pex` and `klayout-pex` in inverter Makefile & README
    [inverter_tb_Vout.sch, inverter_tb_ac_ol.sch, inverter_tb_tran.sch, inverter_top_tb_tran.sch]
2026-05-06 updated CACE for inverter
    [inverter_tb_ac.csv, inverter_tb_ac.sch, inverter_top_tb_ac.csv, inverter_top_tb_ac.sch]
2026-05-06 ran `make sim-cace` target
    [inverter_tb_ac.csv]
2026-05-06 updated plotting Python scripts
    [inverter_tb_Vout.csv, inverter_tb_ac_ol.csv, inverter_top_tb_tran.csv]
2026-05-06 ran `sim-xschem-plot` target
    [inverter_tb_Vout.csv, inverter_tb_ac_ol.csv, inverter_top_tb_tran.csv]
2026-05-07 updated counter librelane
    [pin_order.cfg]
2026-05-07 ran counter librelane
    [counter_top__nom_fast_1p32V_m40C.sdf, counter_top__nom_fast_1p65V_m40C.sdf, counter_top__nom_slow_1p08V_125C.sdf, counter_top__nom_slow_1p35V_125C.sdf, counter_top__nom_typ_1p20V_25C.sdf, counter_top__nom_typ_1p50V_25C.sdf, metrics.csv]
2026-05-07 updated counter macro
    [counter_top__nom_fast_1p32V_m40C.sdf, counter_top__nom_fast_1p65V_m40C.sdf, counter_top__nom_slow_1p08V_125C.sdf, counter_top__nom_slow_1p35V_125C.sdf, counter_top__nom_typ_1p20V_25C.sdf, counter_top__nom_typ_1p50V_25C.sdf, metrics.csv]
2026-05-08 ran counter `make build-top`
    - patched openroad-librelane locally
    [counter_top__nom_fast_1p32V_m40C.sdf, counter_top__nom_fast_1p65V_m40C.sdf, counter_top__nom_slow_1p08V_125C.sdf, counter_top__nom_slow_1p35V_125C.sdf, counter_top__nom_typ_1p20V_25C.sdf, counter_top__nom_typ_1p50V_25C.sdf, metrics.csv]
2026-05-08 relocated Xspice scripts and updated Makefile
    [counter_top_tb_tran.sch]
2026-05-08 ran `make sim-gl-xschem` for counter
    [counter_top_tb_tran.sch]
2026-05-08 removed `counter/flow/final` --> `.gitignore`
    [counter_top__nom_fast_1p32V_m40C.sdf, counter_top__nom_fast_1p65V_m40C.sdf, counter_top__nom_slow_1p08V_125C.sdf, counter_top__nom_slow_1p35V_125C.sdf, counter_top__nom_typ_1p20V_25C.sdf, counter_top__nom_typ_1p50V_25C.sdf, metrics.csv]
2026-05-09 relocated counter Xschem schematics
    - This ensures that the paths work if simulated in schematics and in testbench folder.
2026-05-09 formated inverter Xschem testbenches
    [inverter_tb_ac_ol.sch, inverter_tb_tran.sch, inverter_top_tb_tran.sch]
2026-05-09 added files to `doc` folder
    - ihp-sg13g2-Open-PDK files
    - sizing techsweep PDFs
    - klayout_cheatsheet.md
    - librelane_cheatsheet.md
    [sg13g2_os_layout_cheatsheet.xlsx]
2026-05-09 removed ihp-sg13g2-Open-PDK files
    [sg13g2_os_layout_cheatsheet.xlsx]
2026-05-09 added ihp-sg13g2-Open-PDK files
    [sg13g2_os_layout_cheatsheet.xlsx]
2026-05-09 relocated the inverter schematics and testbenches for consistency (added `xschem` folder)
    [inverter.sch, inverter_tb_Vout.sch, inverter_tb_ac_ol.sch, inverter_tb_tran.sch, inverter_top.sch, inverter_top_tb_tran.sch]
2026-05-09 relocated top-level schematics and testbenches for consistency (added `Xschem` folder)
    [chip_top.sch]
2026-05-10 updated inverter layout (updated pin labels)
2026-05-10 reran inverter macro (fixed testbench paths)
    [inverter_tb_Vout.sch, inverter_tb_ac_ol.sch, inverter_tb_tran.sch, inverter_top_tb_tran.sch]
2026-05-11 updated pin_order.cfg of counter
    [pin_order.cfg]
2026-05-11 updated counter_top_tb_tran.sch (additional bus handling)
    [counter_top_tb_tran.sch]
2026-05-11 updated top-level Xschem schematics and testbench
    - I/O cell convergence is still not good: send to dwarning (see https://github.com/IHP-GmbH/IHP-Open-PDK/pull/931)
    [chip_top.sch, chip_top_tb_tran.sch]
2026-05-11 minor typo fixes --> ready for going public
    [chip_top.sv]
2026-05-12 updated `chip_top_tb_tran.sch` and added custom diode models
    Added
    - xschem/models/cornerDIO_custom.lib
    - xschem/models/diodes_custom.lib
    based on issue: https://github.com/IHP-GmbH/IHP-Open-PDK/issues/921#issuecomment-4432344570
    [chip_top_tb_tran.sch]
2026-05-12 updated `chip_top_tb_tran.sch` (typo in `sram_0_out`)
    [chip_top_tb_tran.sch]
2026-05-13 Replace VDD/VSS with nwell/psub and update symbols
    [inverter.sch]
2026-05-13 Add .save files and include in xschem testbenches
    [inverter_tb_Vout.sch, inverter_tb_tran.sch, inverter_top_tb_tran.sch]
2026-05-13 Clarify AMS sign-off chain with links
2026-05-13 Use wires for inverter inputs; vectorize assigns
2026-05-13 updated `config.yaml` (fixed renaming of loop variables in `chip_core.sv`)
    - Tracking: issue caused by commit: https://github.com/iic-jku/ihp-sg13g2-ams-chip-template/commit/a1322b026df42ddaee2152e0c1a27f86a6ab8ad9
    [config.yaml]
2026-05-14 updated `chip_top_tb_tran.sch` (adapted enable signal)
    [chip_top_tb_tran.sch]
2026-05-16 upgraded from "Apache-2.0" to "Apache-2.0 WITH SHL-2.1" license
    - Solderpad Hardware License (SHL) v2.1: https://solderpad.org/licenses/SHL-2.1/
2026-05-17 renamed inverter testbench from `inverter_tb_Vout.sch` to `inverter_tb_dc_vout.sch`
    [inverter_tb_Vout.csv, inverter_tb_ac_ol.csv, inverter_tb_dc_vout.csv, inverter_tb_dc_vout.sch]
2026-05-19 fixed typo in `config.yaml`
    [config.yaml]
2026-05-22 updated `.designinit`
    Define a shell function that wraps `xschem` with `--rcfile schematic/xschem/xschemrc`, so the project's xschemrc (and its chained per-macro xschemrcs) is loaded regardless of the directory xschem is launched from.
2026-05-23 updated `reorder_spice_pins.py`
    Before the pin-set check the SPICE file is also reconciled against the symbol for 1-bit-bus name flattening: if the symbol declares a port `X[0]` but the SPICE file has the scalar `X` (a common Yosys/LibreLane side-effect when a Verilog bus has width 1), the scalar is renamed to `X[0]` throughout the whole SPICE file (subckt header *and* body) so all internal references stay consistent.
2026-07-14 referenced to RFIC flow (SPARX)
2026-07-20 removed `ntap` / `ptap` from schematics
    [inverter.sch, inverter_top.sch]
2026-07-20 updated `inverter.sch`
    [inverter.sch]
2026-07-21 updated template with new `sak-drc.sh` script, reran DRC flows
    - migrated all KLayout DRC targets (top-level, `inverter` macro, bondpad, logos) from direct `run_drc.py` invocations to `sak-drc.sh -k`, removing five duplicated `run_drc.py` blocks
    - added `DRC_LEVEL=<precheck|macro|regular>` (default: `macro`) to select the KLayout DRC level; `klayout-drc-minimum`/`-regular` map to the `precheck`/`regular` presets
    - fixed `klayout-drc-minimum`/`-regular` to check the actual top cell `chip_top_logo_fill` (previously `--topcell=chip_top`, which excluded the logo and fill structures from the check)
    - updated `magic-drc` to the new single-argument CLI; the `inverter` target now uses `$(_GDS_EXT)`,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
2026-07-21 executed `make all` and `make release` --> ready for `2026.07` IIC-OSIC-TOOLS release
    [inverter_tb_ac.csv]
2026-07-25 updated counter GL simulation flow (`reorder_xspice_pins.py`, `spi2xspice.py`)
2026-07-27 relocated pin reorder scripts to IIC-OSIC-TOOLS container
2026-07-30 relocated `plot_simulations` in counter macro
    [counter_top_tb_tran.csv, counter_top_tb_tran.sch]
2026-07-30 relocated `plot_simulations` in inverter macro
    [inverter_tb_ac_ol.csv, inverter_tb_ac_ol.sch, inverter_tb_dc_vout.csv, inverter_tb_dc_vout.sch, inverter_tb_tran.sch, inverter_top_tb_tran.csv, inverter_top_tb_tran.sch]
2026-07-30 relocated `plot_simulations` in top-level
    [chip_top_tb_tran.csv, chip_top_tb_tran.sch]
2026-07-31 updated inverter cell testbenches
    [inverter_tb_ac_ol.sch, inverter_tb_dc_vout.sch, inverter_tb_tran.sch]
2026-07-31 executed `make all` and `make release`
    [counter_top_tb_tran.csv, inverter_tb_ac_ol.csv, inverter_tb_dc_vout.csv, inverter_top_tb_tran.csv]
2026-07-31 updated `inverter_top.sch`
    [inverter_top.sch]
2026-08-18 reverted `config.yaml` changes with `AUTO_TAPER_NDR_NETS`
    - wait until `librelane-openroad` is updated
    [config.yaml]
2026-08-20 swapped lay2img.py to sak-render.py
    [config.yaml]
2026-08-20 added mm_ok=1 to all transistors
    [inverter.sch]
2026-08-20 updated all testbenches: changed `.param temp=xxx` to `.temp xxx`
    [chip_top_tb_tran.sch, counter_top_tb_tran.sch, inverter_tb_ac_ol.sch, inverter_tb_dc_vout.sch, inverter_tb_tran.sch, inverter_top_tb_tran.sch]
2026-08-21 added SAVE code_shown.sym and updated "Simulate" launcher in all testbenches
    [chip_top_tb_tran.sch, counter_top_tb_tran.sch, inverter_tb_ac_ol.sch, inverter_tb_dc_vout.sch, inverter_tb_tran.sch, inverter_top_tb_tran.sch]
2026-08-23 added PEX targets to counter macro
    [counter_top_tb_tran.sch]
2026-08-24 reworked counter FPGA flow to support three boards
    [pico-ice.pcf]
2026-08-24 ran `make clean-all` and `make all`
    [chip_top.sch, chip_top_tb_tran.csv, chip_top_tb_tran.sch]
2026-08-24 merged fpga board fragments into the board Makefiles
    Each board's Makefile now holds all of its configuration (ARCH, device, package, pin file, programmer), so one file answers every question about a board.
    fpga.mk now fails fast with a clear error when a mandatory variable is missing, instead of misbehaving on a wrong include order.
    dut.mk, fpga.mk and arch/ stay shared, see macros/counter/fpga/README.md.
    All three board flows rebuilt bit-identical bitstreams after the change.
2026-08-24 polished documentation, figures and tutorial for release
    Repo-wide consistency and proofreading sweep over the tutorial, the top-level and macro READMEs, and the IP READMEs.
    The targets_overview figure now matches the Makefile recipes (magic-pex added to the digital branch, klayout-drc dropped from the make all step) and all exports were regenerated from the updated drawio source.
    Factual fixes include the swapped analog/digital inverter numbering in the chip simulation captions, inverter_top.sym in the Xschem library paragraph, the render-gds prerequisite, the ULX3S programmer variable claim, and the feedback-resistor starting value in exercise 2.
    Escaped pipes inside code spans in table ro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
2026-08-24 fixed `chip_top_tb_tran.sch` (issue with sg13g2_io.spi)
    [chip_top_tb_tran.sch]
2026-08-24 added the PR boundary guard and fixed the CACE postprocess hook
    Added `check-boundary` (`scripts/check_boundary.py`) to the inverter and run it first in `build-top`, so a top-cell layout without a shape on the PR boundary layer 189 fails the macro build instead of the chip flow, which derives every macro's bounding box from it (`get_bbox.tcl` in `Magic.StreamOut`).
    The README documents the rule: never delete the box, keep it in the KLayout editing source, hide it at render time with `sak-render.py -x`.
    Silenced the two debug prints in the CACE postprocess hook, because CACE 2.11.0 redirects the script's stdout into its rich logger and recurses without end on the first print, which made `make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
2026-08-25 dropped three dead paths from REUSE.toml
    macros/counter/fpga/counter_top.asc, .bin and .json have matched nothing since a68a59f moved the FPGA outputs to <board>/build/, which .gitignore excludes. The annotation block keeps README.md and pin_order.cfg, both of which are tracked and carry no SPDX header of their own.
    reuse lint reports 381 of 381 files compliant after the change.
2026-08-25 fixed the duplicate VSS pin that broke the PEX pin reorder
    `chip_top.sch` labelled both ground pads VSS, so `chip_top.sym` carried the pin name twice and `sak-pin-reorder.py` aborted with a pin count mismatch of 32 against 31. A `.subckt` port list holds one entry per net, so the same name cannot appear twice. The 32-port netlist that used to work was written by the old `reorder_spice_pins.py` from `pin_order.txt`, not by Magic.
    The IO ground pad `x8` (`sg13g2_IOPadIOVss`), its supply ring and the matching symbol pin are now labelled IOVSS, which is what `chip_top.sv`, the LibreLane netlist `netlist/spice/chip_top.spice` and the pin labels of the GDS have called it all along. The ring assig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
    [chip_top.sch]
2026-08-25 updated top-level schematics
    [chip_top_tb_tran.sch]
2026-08-25 kept the full pad ring visible on the PEX symbol
    `symbol-pex` deleted the merged supply pin and its text label, so the generated `<CELL>_pex.sym` lost part of the pinout it is meant to show. Only the pin box carries connectivity, the label is drawing, so the label stays and `IOVSS` is still readable on the PEX symbol next to the pin box that is gone.
    The pin dropping moved out of the make recipe into [`scripts/prune_pex_symbol.py`](scripts/prune_pex_symbol.py), which also drops every repeat of a pin name after the first. A chip that draws one pin per bond pad puts several pins of the same name on its symbol, and a `.subckt` port list holds one entry per net, so the pads that share a supply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
2026-08-26 [Server] execute magic-pex, all and release targets
    [chip_top_tb_tran.sch]
2026-09-04 expanded the analog macro tutorial with the HeiChips workshop hands-on content
    The HeiChips 2026 analog workshop (https://heichips.github.io/heichips26-analog-workshop/) was written from this macro but explains the manual steps in much more detail. Its hands-on content is folded back into the analog macro section, adapted to the ihp-sg13g2 files and the IIC-OSIC-TOOLS container.
    New: the inverter circuit figure with its dummy devices, a Getting Started with Xschem section with the shortcut table, an Anatomy of the AC Testbench walk-through covering the spice_ignore spares, the model includes, the control block, the measurements and the FET .save file, step-by-step schematic and symbol drawi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
2026-09-04 fixed the tutorial figure pre-conversion, whose glob reached no figure at all
    The `fig-pdf` helper globbed `fig/*.svg` while every figure lives one level deeper in a per-topic subfolder, so it converted nothing, `make clean`'s `rm -f fig/*.pdf` deleted nothing, and the PDF render died in the Quarto Lua filter on exactly the rsvg-convert defect the helper exists to work around. It stayed hidden because it only fires on Windows: CI installs librsvg2-bin and lets Quarto convert the figures itself.
    Both loops now recurse with `find`, and both skip figure PDFs that git tracks. `targets_overview.pdf` and `tools_overview.pdf` are draw.io exports committed next to their SVG, so a recursive conversi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
2026-10-12 corrected the DRC level table in `README.md` and the tutorial
    The table described generic checks instead of what `sak-drc.sh` passes to the PDK's `run_drc.py`. For the IHP Open-PDK, `precheck` runs the foundry precheck rule set, `macro` adds the full FEOL and BEOL rules with off-grid, angle and recommended rules, and `regular` adds density, the extra rules and antenna. `run_drc.py` adds the pin checks at every level, and the PDK has no zero-area check. The README also names the flags of each level.
2026-10-14 fixed the regular KLayout DRC of the filled chip GDS
    `klayout-drc-regular` reported 70506 items on `layout/chip_top_logo_fill.gds.gz`. With this change it reports 219.
    - `FILL_DIST_TM=2.0` put the TopMetal filler shapes closer than the 3.0 um minimum filler space (34818 `TM1Fil.b`, 35461 `TM2Fil.b`). It is back at the PDK default of 3.05 um.
    - The density deck takes the chip area from `prBoundary.drawing` (189/0), which a LibreLane chip carries only inside its placed macros, so it reported 8 false maximum-density violations (`AFil.g1`, `M1.k` to `M5.k`, `TM1.d`, `TM2.d`). `add_logo_fill.sh` now adds the die outline on 189/0, as the sg13cmos5l template does.
    - Measured against the die, Metal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
2026-10-16 updated the tutorial for `make project`
    The new chapter "Start Your Own Chip" explains what `make project` does, which names it changes and what follows it. The overview, the Workflow tip, the top-level targets table and the top-level chapter point to it. The `scripts/` row of the folder table no longer lists rendering and plotting scripts, which live elsewhere.
    The README section and the report of `make project` now run `make init-submodules` before `make build-top`, because a fresh clone lacks `flow/artistic` and `build-top` does not fetch it.
2026-10-17 made the template wording neutral and recommended the `ihp-sg13g2-<name>` repository name
    Eleven lines called the chip the template and stayed wrong in a chip started with `make project`: the `Makefile` header, the bondplan caption and two sentences of the README, `doc/floorplan.md`, `doc/specifications.md`, the CACE description of the inverter, the packaging README and config, and `AGENTS.md`. They now read true in both, so the report of `make project` lists no such line for a fresh chip.
    The README section and the tutorial recommend naming the repository `ihp-sg13g2-<name>`, and `make project` prints the steps to rename the repository, `origin` and the folder when the folder has another n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
