iic-jku/ihp-sg13g2-ams-chip-template/(notices)

Notices in the files:
README.md:
License: Solderpad Hardware License v2.1
